gnixoag/PHL-03-/1.jpg

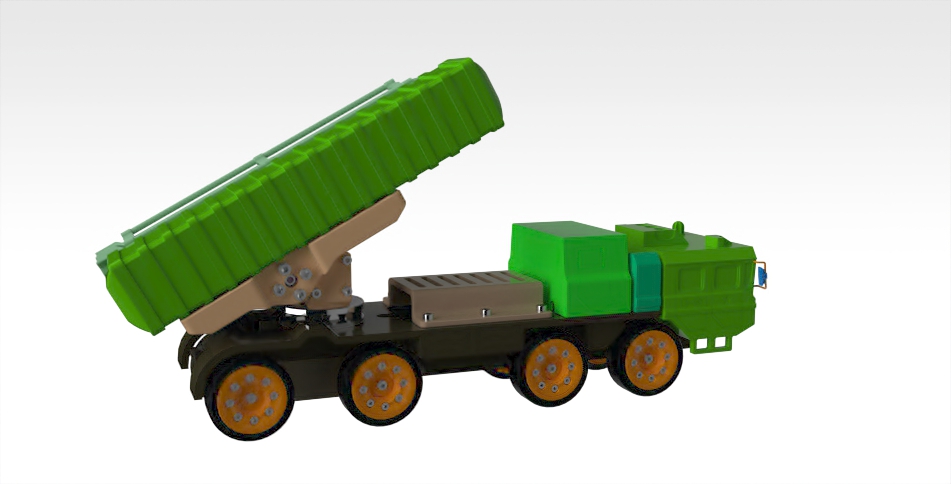
1.jpg
