gnixoag/PHL-03-/PHL-03式远程火箭炮_asm1.tif

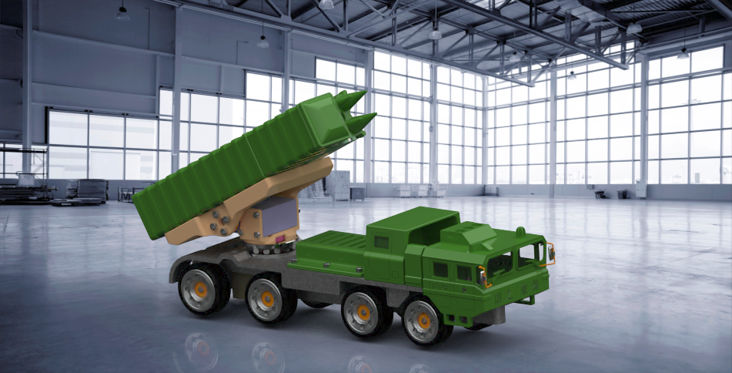
PHL-03式远程火箭炮_asm1.tif
