gnixoag/PHL-03-/2.jpg

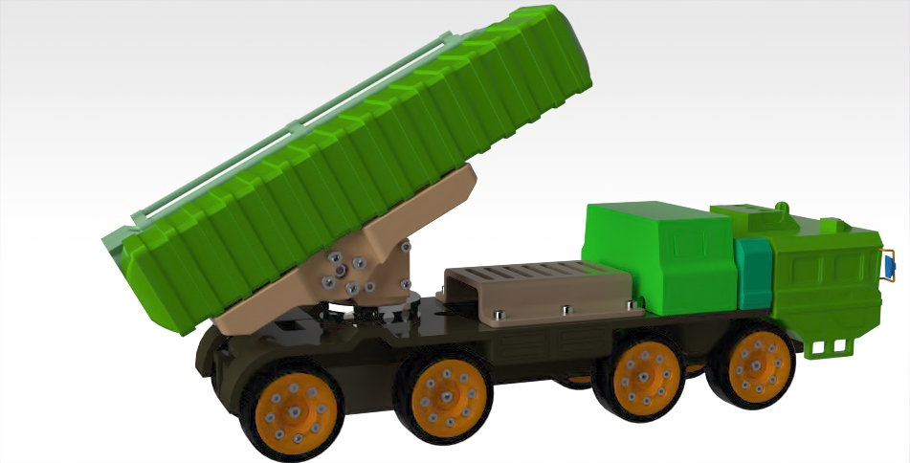
2.jpg
