gnixoag/PHL-03-/单轴舵机.jpg

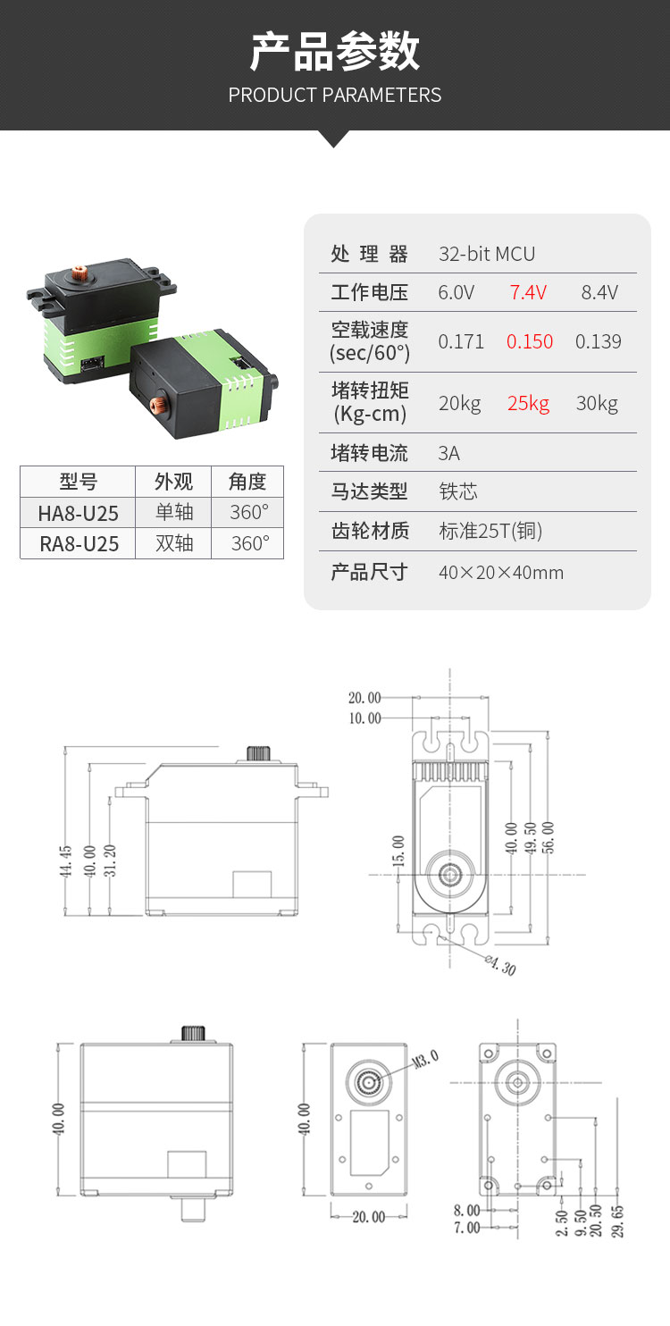
单轴舵机.jpg
