gnixoag/PHL-03-/双轴舵机.jpg

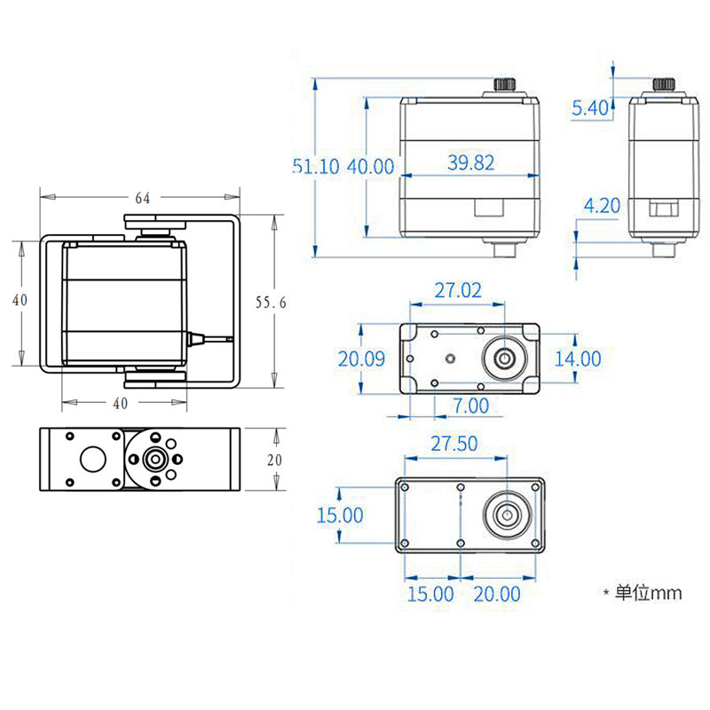
双轴舵机.jpg
