gnixoag/PHL-03-/(list of files, cad)

Other CAD files:
GB-T276_60000_2Z-1994,619I6_2Z.prt
GB-T292_B_C-1994,B723_C.prt
GB-T4663_80000-1994,81105.prt
GB-T70.1-2000,M2.5x6.prt
GB-T70.1-2000,M2x6.prt
GB-T70.1-2000,M3x10.prt
GB-T70.1-2000,M3x30.prt
GB-T70.1-2000,M3x40.prt
GB-T70.1-2000,M3x6.prt
GB-T70.1-2000,M3x8.prt
GB-T70.1-2000,M4x12.prt
GB-T70.1-2000,M4x8.prt
PHL-03副转盘.prt
PHL-03反光镜.prt
PHL-03右反光镜架.prt
PHL-03左反光镜架.prt
PHL-03式远程火箭炮_asm1.prt
PHL-03指挥舱.prt
PHL-03推力转盘.prt
PHL-03水箱.prt
PHL-03炮筒架.prt
PHL-03电池夹.prt
PHL-03车头.prt
PHL-03车头架.prt
PHL-03车架.prt
PHL-03车轮组件_asm1.prt
PHL-03车轴.prt
PHL-03轮毂.prt
PHL-03轮毂盖.prt
PHL-03轮毂轴承盖.prt
PHL-03轮胎.prt
单轴舵机.prt
双轴舵机.prt
火龙-140固体发动机段.prt
火龙-140安装板.prt
火龙-140尾翼.prt
火龙-140引信.prt
火龙-140战斗部.prt
火龙-140火箭弹_asm1.prt
火龙-140火箭架.prt
火龙-480制动器.prt
火龙-480制导弹头.prt
火龙-480发射箱盖.prt
火龙-480发射箱（一段）.prt
火龙-480发射箱（二段）.prt
火龙-480尾翼.prt
火龙-480尾翼段.prt
火龙-480弹簧芯.prt
火龙-480战斗部.prt
火龙-480推进器.prt
火龙-480火箭弹_asm1.prt
直杆型导向轴CSFD-D3-L159.prt
舵盘.prt
