gnixoag/PHL-03-/PHL-03式远程火箭炮图纸2019.10.30.pdf

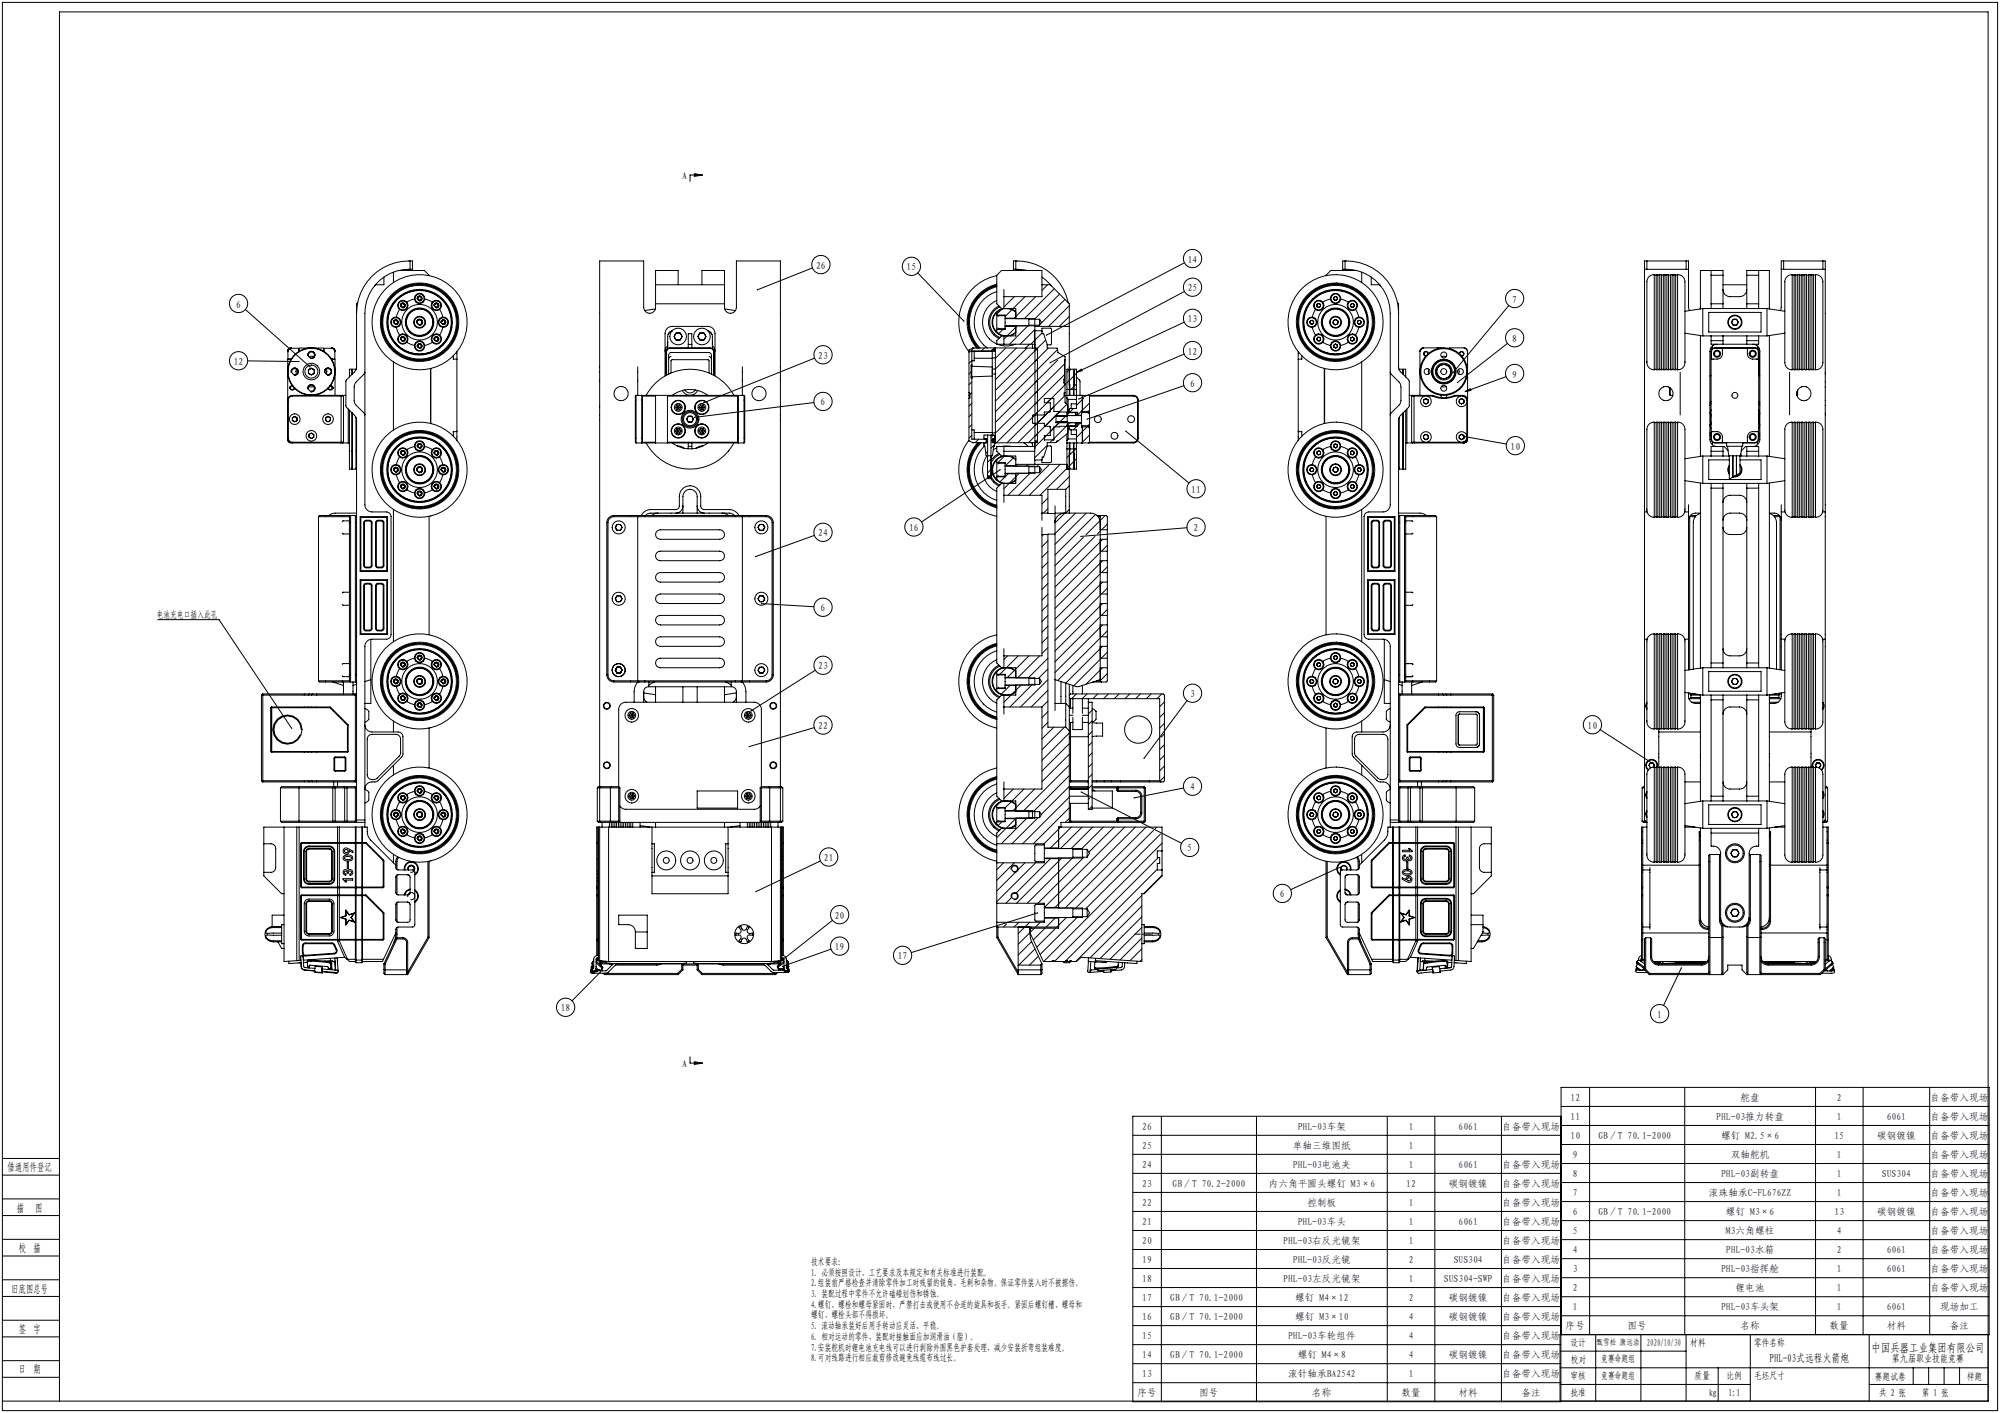
[picture p6: page 1]

12 | | 舵盘 | 2 | | 自备带入现场

11 | | PHL-03推力转盘 | 1 | 6061 | 自备带入现场

26 | | PHL-03车架 | 1 | 6061 | 自备带入现场

10 | GB／T 70.1-2000 | 螺钉 M2.5×6 | 15 | 碳钢镀镍 | 自备带入现场

25 | | 单轴三维图纸 | 1

9 | | 双轴舵机 | 1 | | 自备带入现场

24 | | PHL-03电池夹 | 1 | 6061 | 自备带入现场

8 | | PHL-03副转盘 | 1 | SUS304 | 自备带入现场

23 | GB／T 70.2-2000 | 内六角平圆头螺钉 M3×6 | 12 | 碳钢镀镍 | 自备带入现场

7 | | 滚珠轴承C-FL676ZZ | 1 | | 自备带入现场

22 | | 控制板 | 1 | | 自备带入现场

6 | GB／T 70.1-2000 | 螺钉 M3×6 | 13 | 碳钢镀镍 | 自备带入现场

21 | | PHL-03车头 | 1 | 6061 | 自备带入现场

5 | | M3六角螺柱 | 4 | | 自备带入现场

20 | | PHL-03右反光镜架 | 1 | | 自备带入现场

技术要求：
1. 必须按照设计、工艺要求及本规定和有关标准进行装配。
2.组装前严格检查并清除零件加工时残留的锐角、毛刺和杂物。保证零件装入时不被擦伤。
3. 装配过程中零件不允许磕碰划伤和锈蚀。
4.螺钉、螺栓和螺母紧固时，严禁打击或使用不合适的旋具和扳手。紧固后螺钉槽、螺母和
螺钉、螺栓头部不得损坏。
5. 滚动轴承装好后用手转动应灵活、平稳。
6. 相对运动的零件，装配时接触面应加润滑油（脂）。
7.安装舵机时锂电池充电线可以进行剥除外围黑色护套处理，减少安装折弯组装难度。
8.可对线路进行相应裁剪修改避免线缆布线过长。

19 | | PHL-03反光镜 | 2 | SUS304 | 自备带入现场

18 | | PHL-03左反光镜架 | 1 | SUS304-SWP | 自备带入现场

17 | GB／T 70.1-2000 | 螺钉 M4×12 | 2 | 碳钢镀镍 | 自备带入现场

1 | | PHL-03车头架 | 1 | 6061 | 现场加工

16 | GB／T 70.1-2000 | 螺钉 M3×10 | 4 | 碳钢镀镍 | 自备带入现场

序号 | 图号 | 名称 | 数量 | 材料 | 备注
设计 | 甄雪松 康远浩 | 2020/10/30 | 材料 | 零件名称 PHL-03式远程火箭炮 | 中国兵器工业集团有限公司 第九届职业技能竞赛
校对 | 竞赛命题组

14 | GB／T 70.1-2000 | 螺钉 M4×8 | 4 | 碳钢镀镍 | 自备带入现场

审核 | 竞赛命题组 | | 质量 | 比例 | 毛坯尺寸 | 赛题试卷 | | 样题

13 | | 滚针轴承BA2542 | 1 | | 自备带入现场

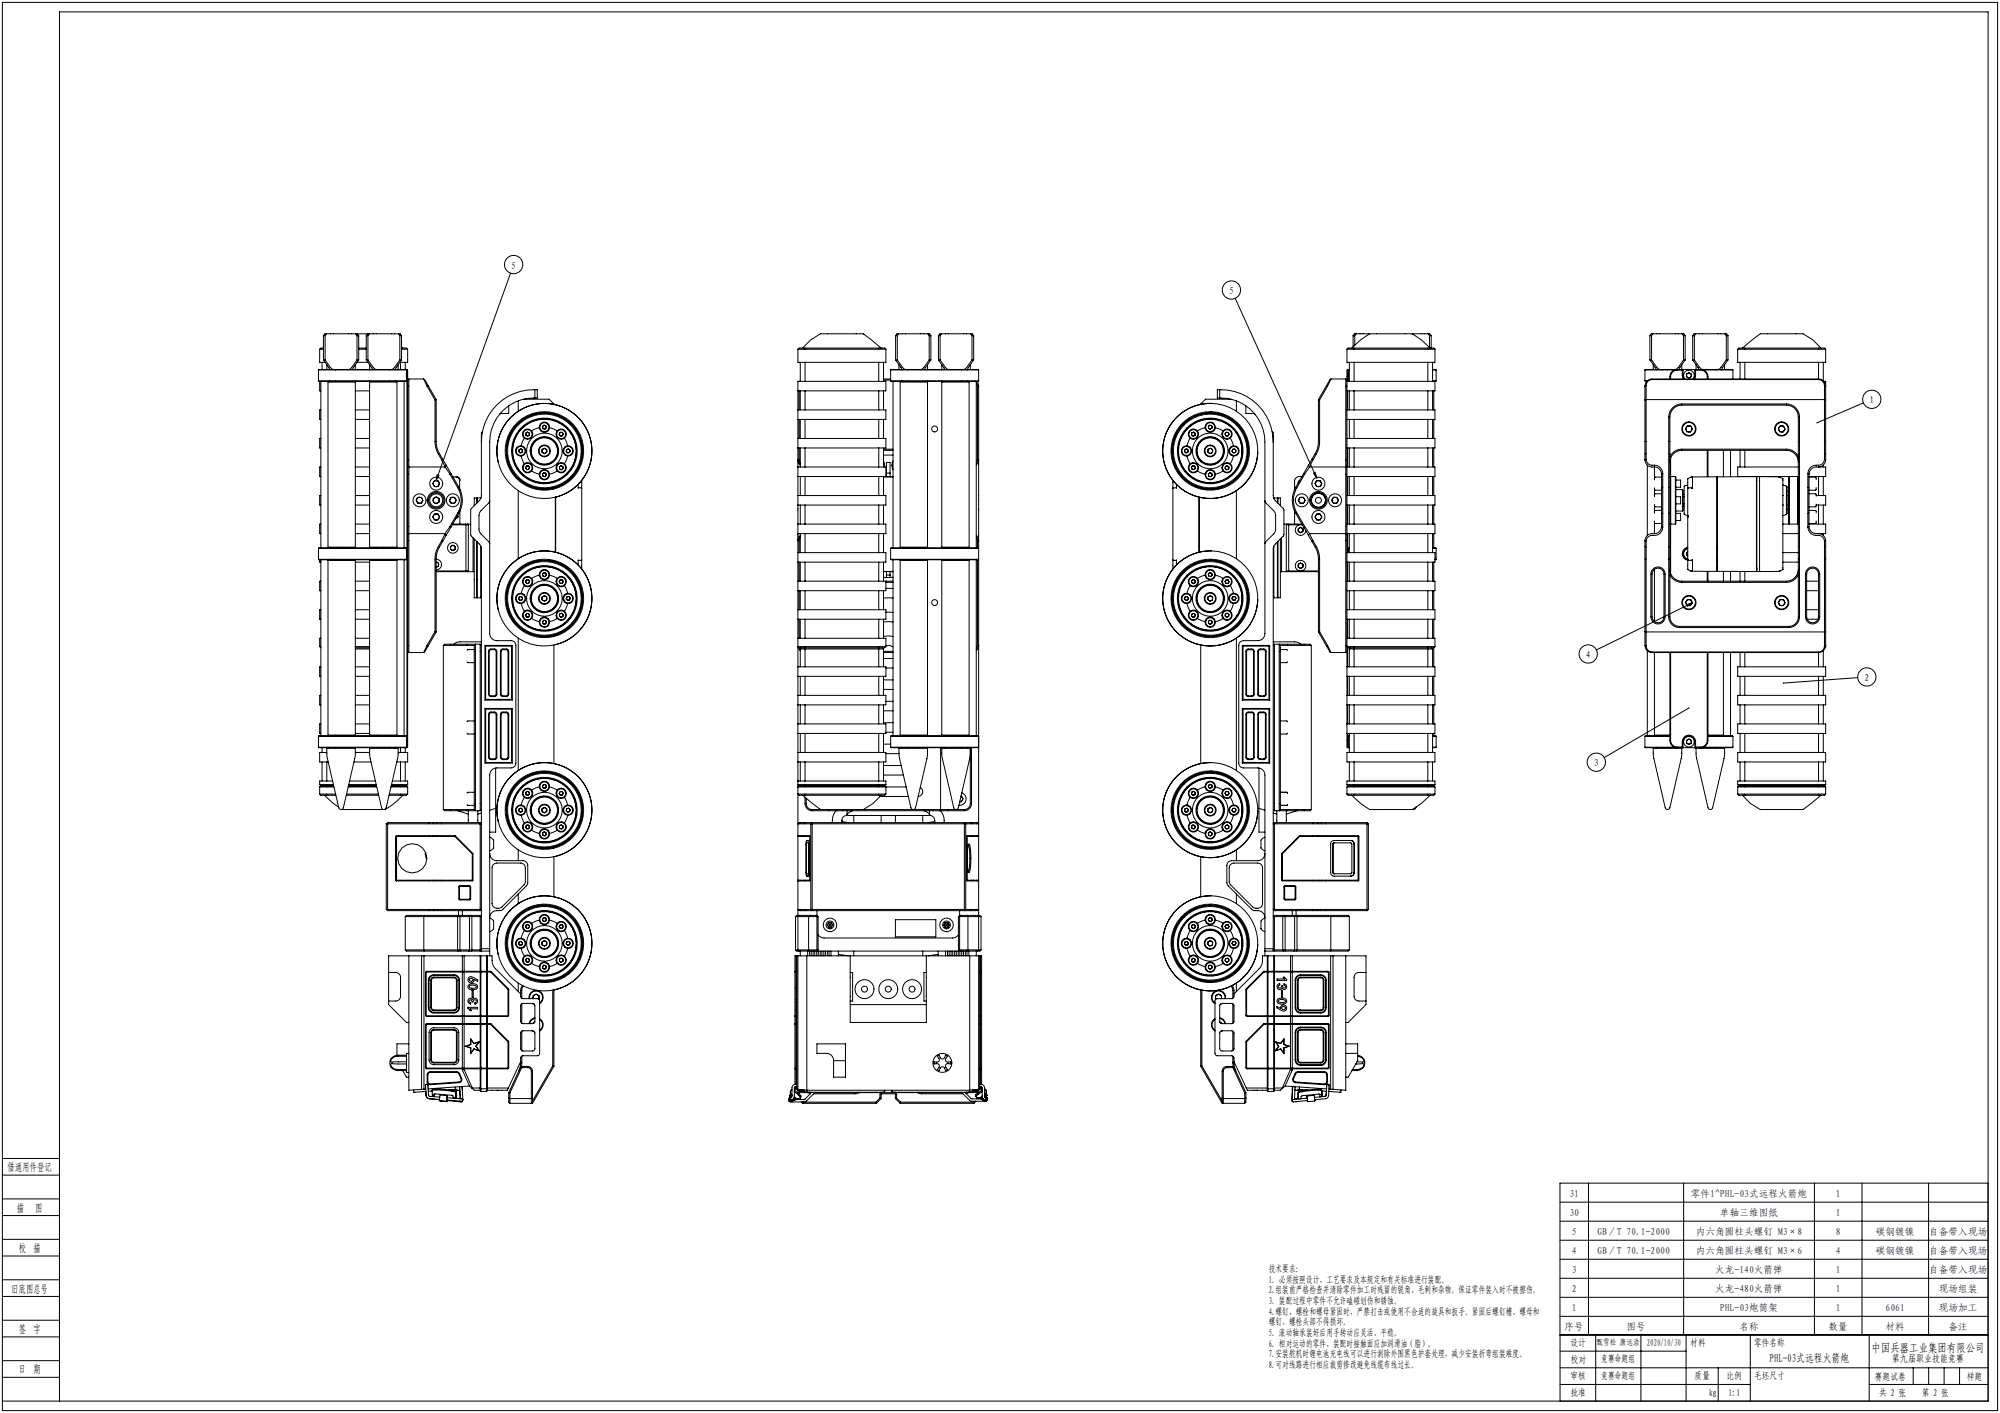
[picture p7: page 2]
内六角圆柱头螺钉 M3×6; 碳钢镀镍; 自备带入现场

31 | | 零件1^PHL-03式远程火箭炮 | 1

30 | | 单轴三维图纸 | 1

5 | GB／T 70.1-2000 | 内六角圆柱头螺钉 M3×8 | 8 | 碳钢镀镍 | 自备带入现场

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

1 | | PHL-03炮筒架 | 1 | 6061 | 现场加工

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

竞赛命题组 | 质量 | | 毛坯尺寸 | | 样题

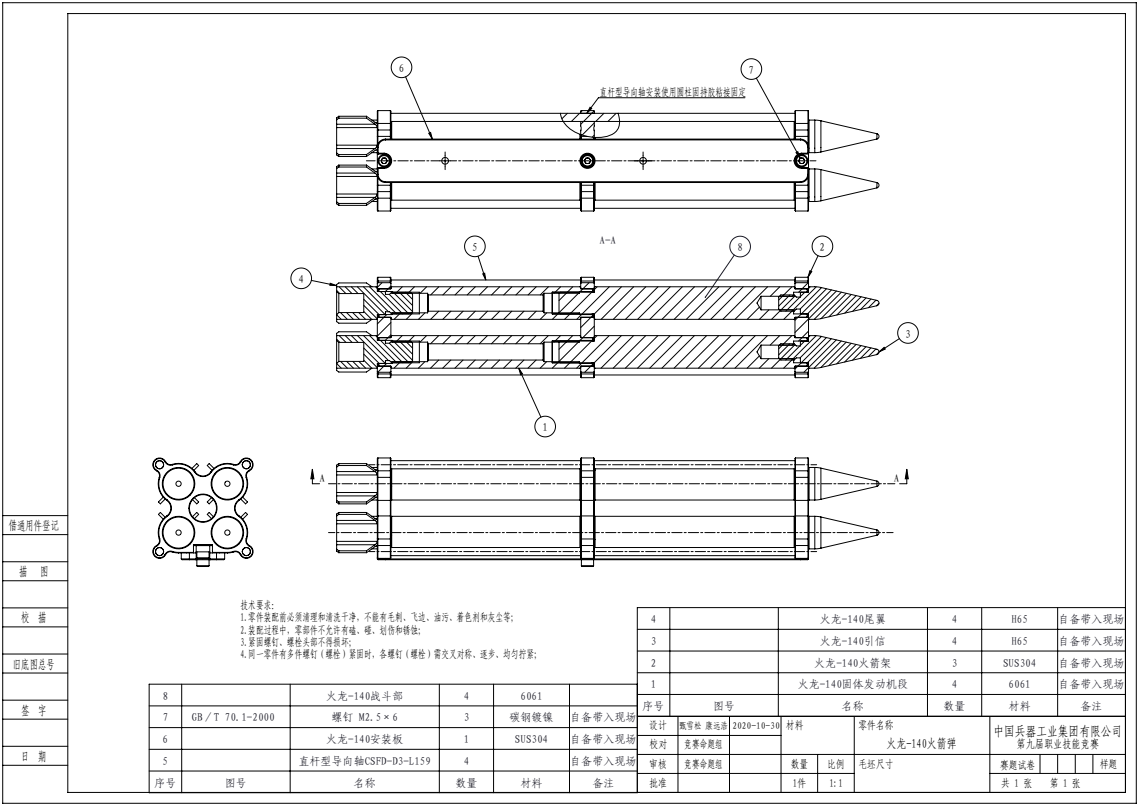
[picture p8: page 3]

技术要求：
1.零件装配前必须清理和清洗干净，不能有毛刺、飞边、油污、着色剂和灰尘等；
2.装配过程中，零部件不允许有磕、碰、划伤和锈蚀；
3.紧固螺钉、螺栓头部不得损坏；
4.同一零件有多件螺钉（螺栓）紧固时，各螺钉（螺栓）需交叉对称、逐步、均匀拧紧；

3 | | 火龙-140引信 | 4 | H65 | 自备带入现场

2 | | 火龙-140火箭架 | 3 | SUS304 | 自备带入现场

1 | | 火龙-140固体发动机段 | 4 | 6061 | 自备带入现场

8 | | 火龙-140战斗部 | 4 | 6061

序号 | 图号 | 名称 | 数量 | 材料 | 备注
设计 | 甄雪松 康远浩 | 2020-10-30 | 材料 | 零件名称 火龙-140火箭弹 | 中国兵器工业集团有限公司

7 | GB／T 70.1-2000 | 螺钉 M2.5×6 | 3 | 碳钢镀镍 | 自备带入现场

6 | | 火龙-140安装板 | 1 | SUS304 | 自备带入现场

5 | | 直杆型导向轴CSFD-D3-L159 | 4 | | 自备带入现场

数量 | | | | 样题
1件 | 1:1 | | 共 1 张 第 1 张

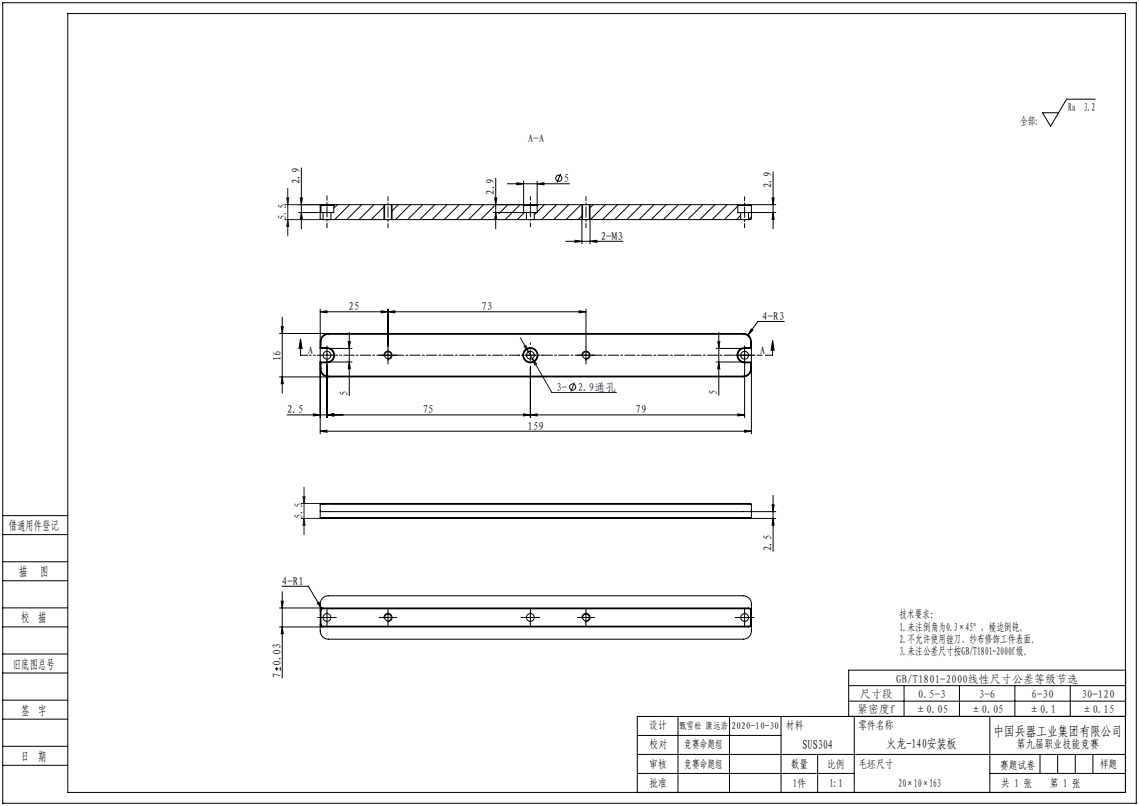
[picture p9: page 4]
甄雪松 康远浩

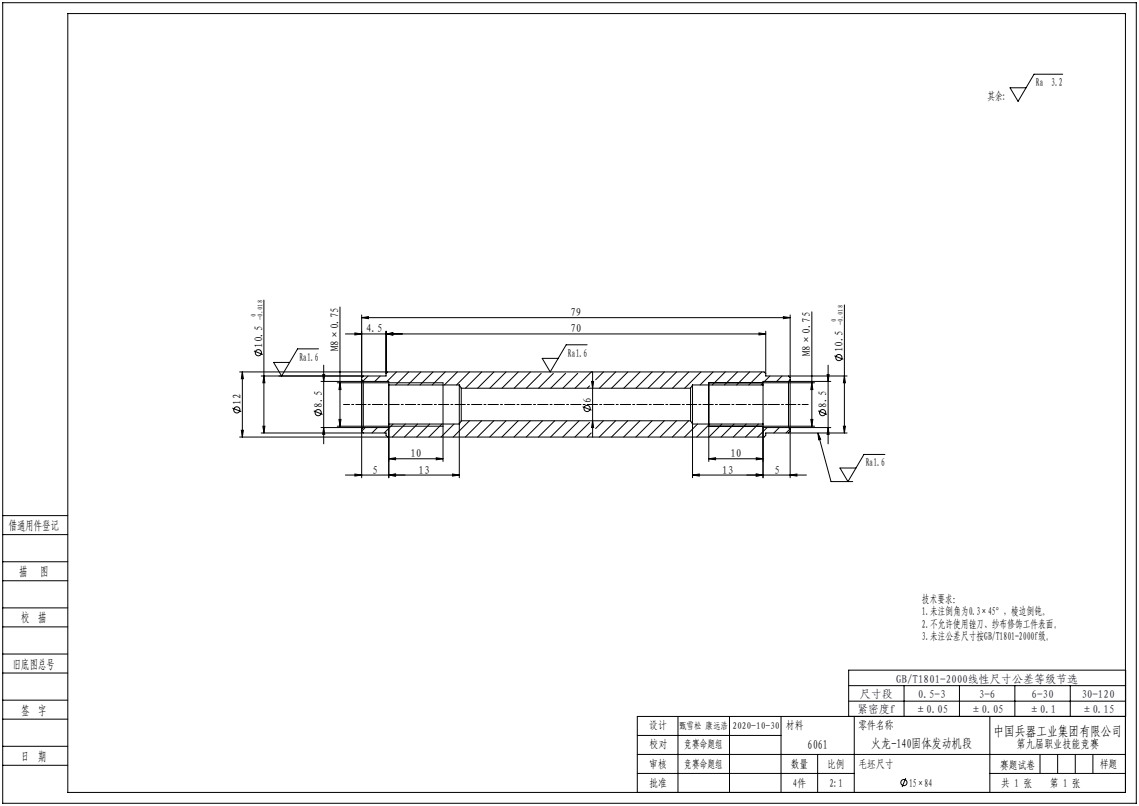
[picture p10: page 5]
甄雪松 康远浩

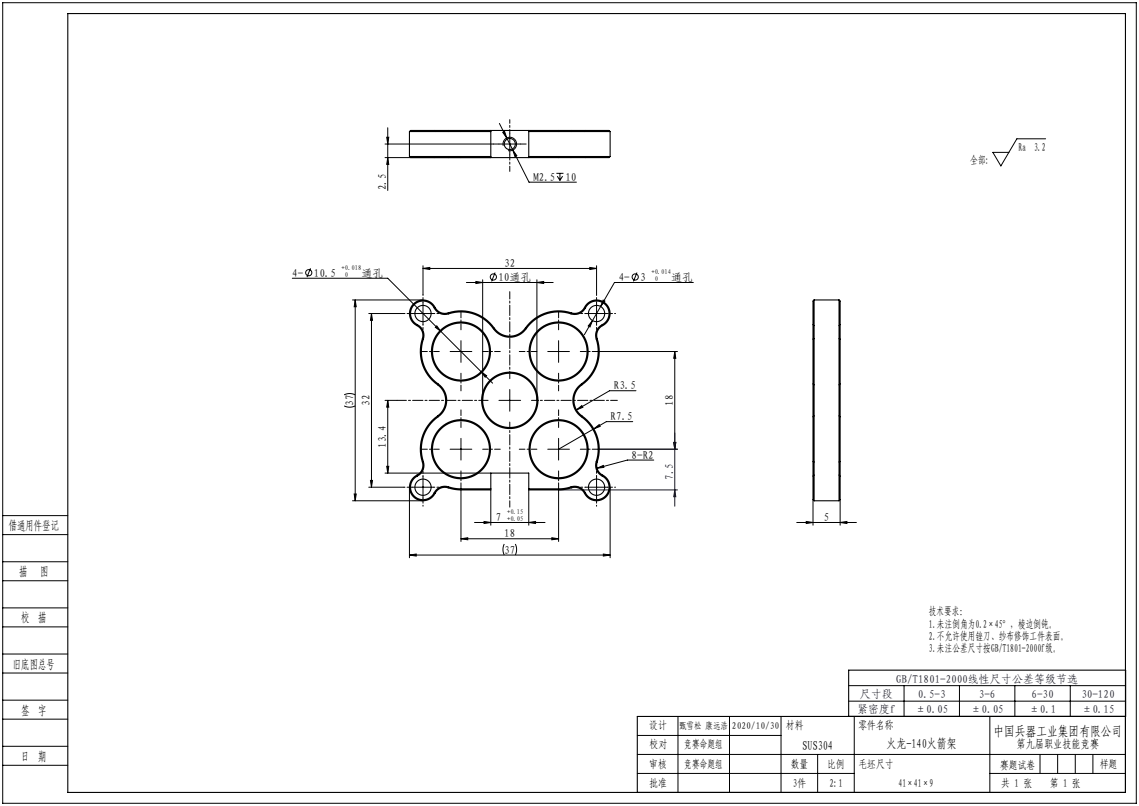
[picture p11: page 6]
甄雪松 康远浩

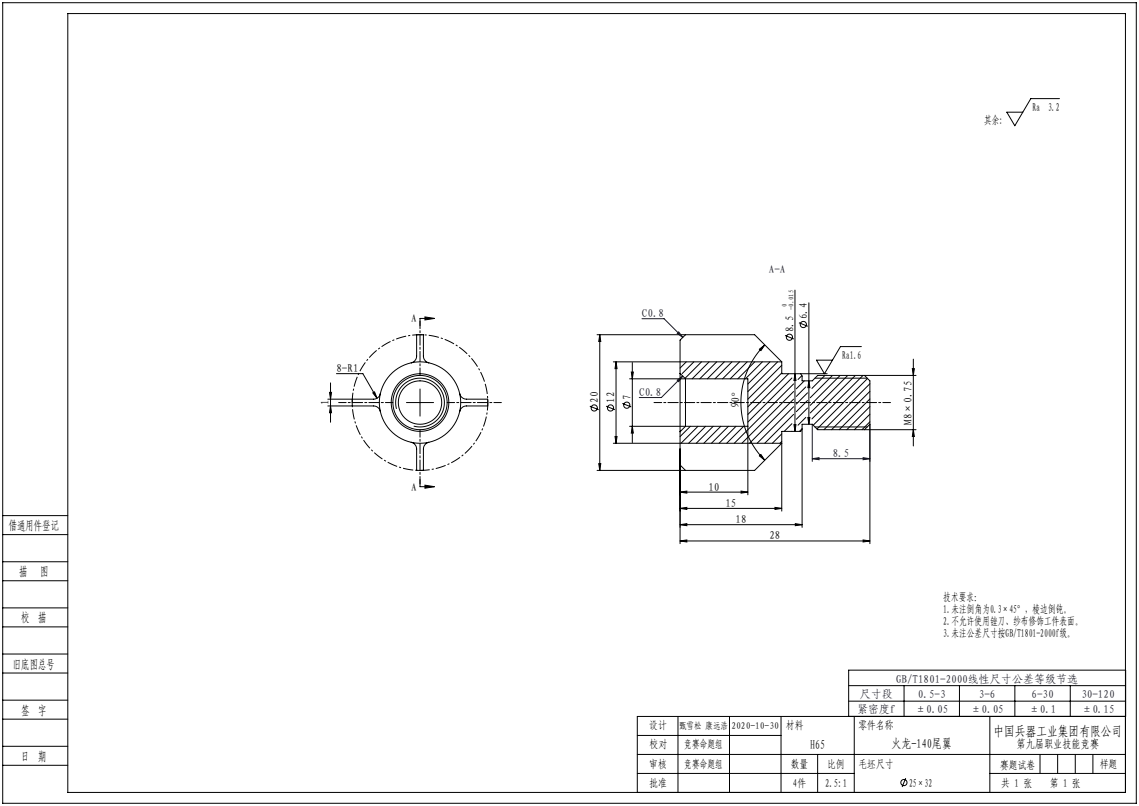
[picture p12: page 7]
甄雪松 康远浩

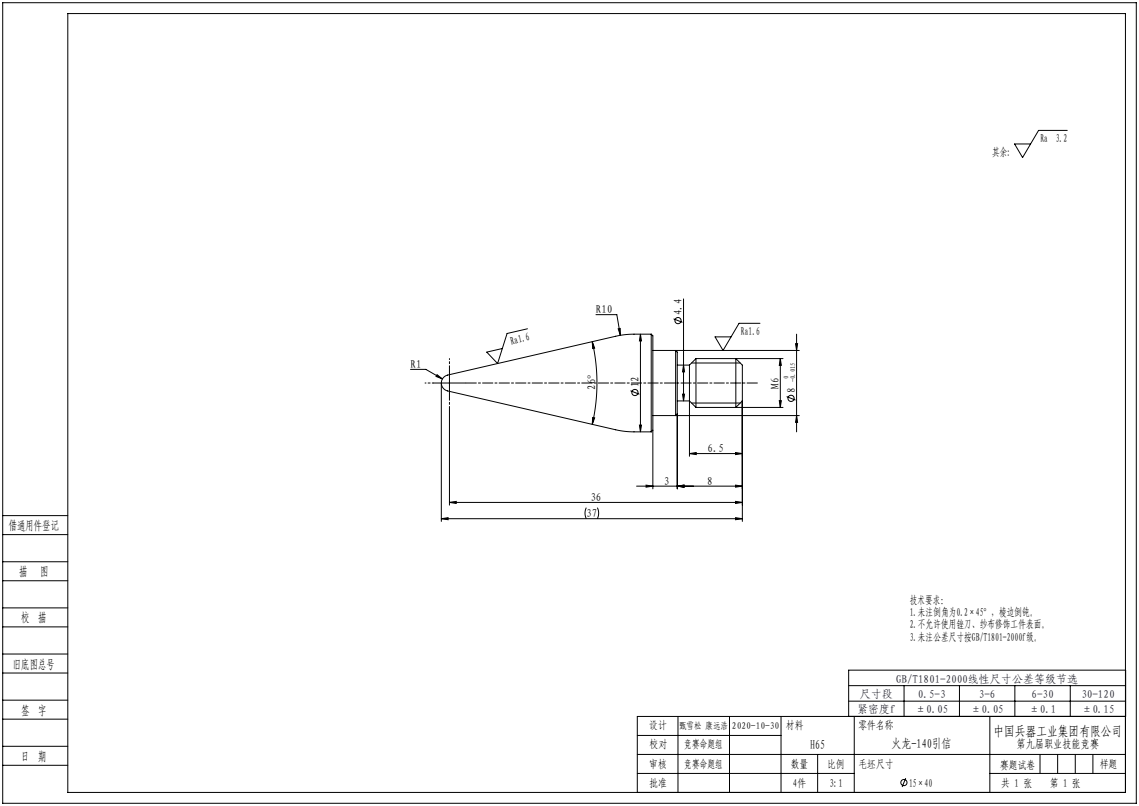
[picture p13: page 8]
甄雪松 康远浩

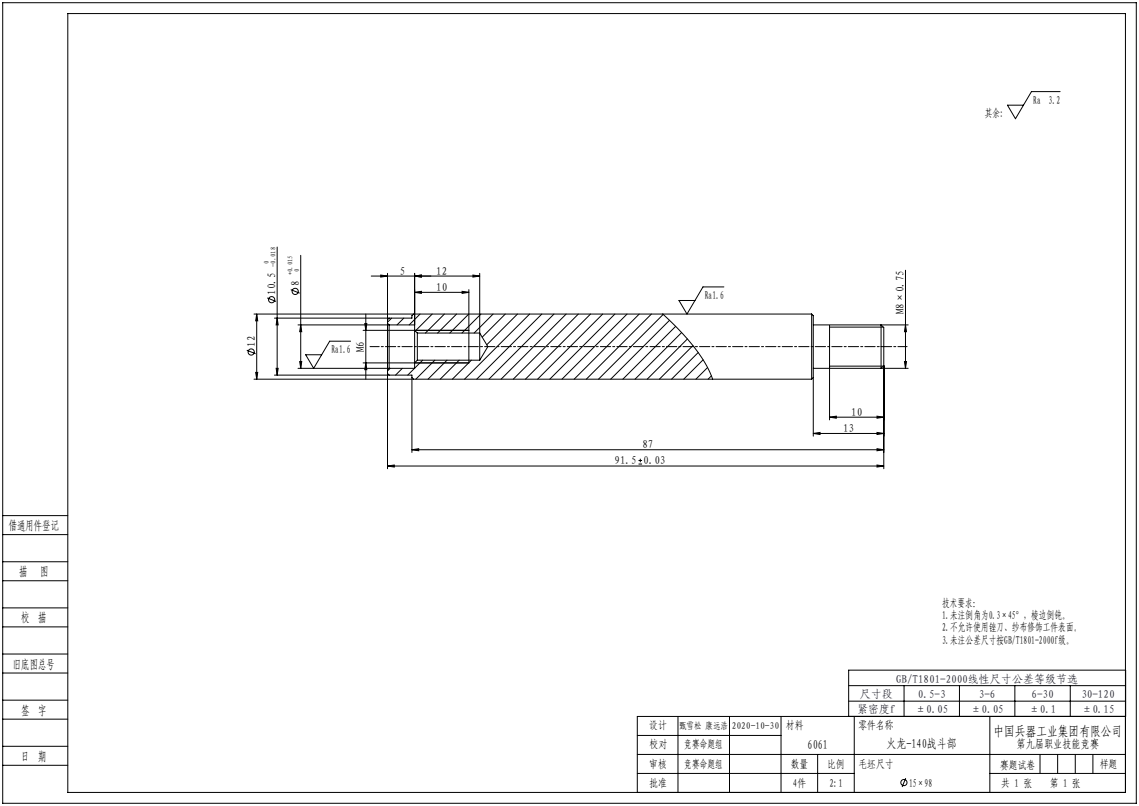
[picture p14: page 9]
甄雪松 康远浩

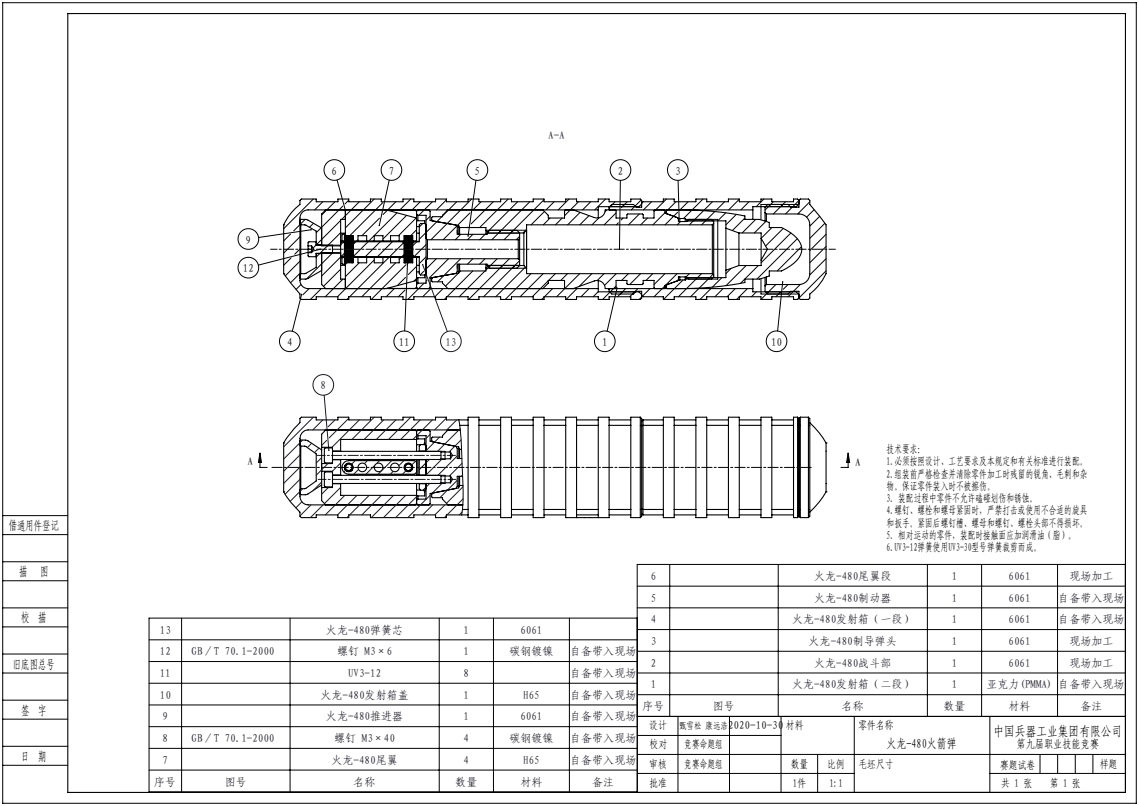
[picture p15: page 10]

技术要求：
1.必须按照设计、工艺要求及本规定和有关标准进行装配。
2.组装前严格检查并清除零件加工时残留的锐角、毛刺和杂
物。保证零件装入时不被擦伤。
3. 装配过程中零件不允许磕碰划伤和锈蚀。
4.螺钉、螺栓和螺母紧固时，严禁打击或使用不合适的旋具
和扳手。紧固后螺钉槽、螺母和螺钉、螺栓头部不得损坏。
5. 相对运动的零件，装配时接触面应加润滑油（脂）。
6.UV3-12弹簧使用UV3-30型号弹簧裁剪而成。

6 | 火龙-480尾翼段 | 1 | 6061 | 现场加工

5 | 火龙-480制动器 | 1 | 6061 | 自备带入现场

13 | | 火龙-480弹簧芯 | 1 | 6061

3 | | 火龙-480制导弹头 | 1 | 6061 | 现场加工

12 | GB／T 70.1-2000 | 螺钉 M3×6 | 1 | 碳钢镀镍 | 自备带入现场

2 | | 火龙-480战斗部 | 1 | 6061 | 现场加工

11 | | UV3-12 | 8 | | 自备带入现场

1 | | 火龙-480发射箱（二段） | 1 | 亚克力(PMMA) | 自备带入现场

10 | | 火龙-480发射箱盖 | 1 | H65 | 自备带入现场

序号 | 图号 | 名称 | 数量 | 材料 | 备注
设计 | 甄雪松 康远浩2020-10-30 | | 材料 | 零件名称 火龙-480火箭弹 | 中国兵器工业集团有限公司

9 | | 火龙-480推进器 | 1 | 6061 | 自备带入现场

8 | GB／T 70.1-2000 | 螺钉 M3×40 | 4 | 碳钢镀镍 | 自备带入现场

7 | | 火龙-480尾翼 | 4 | H65 | 自备带入现场

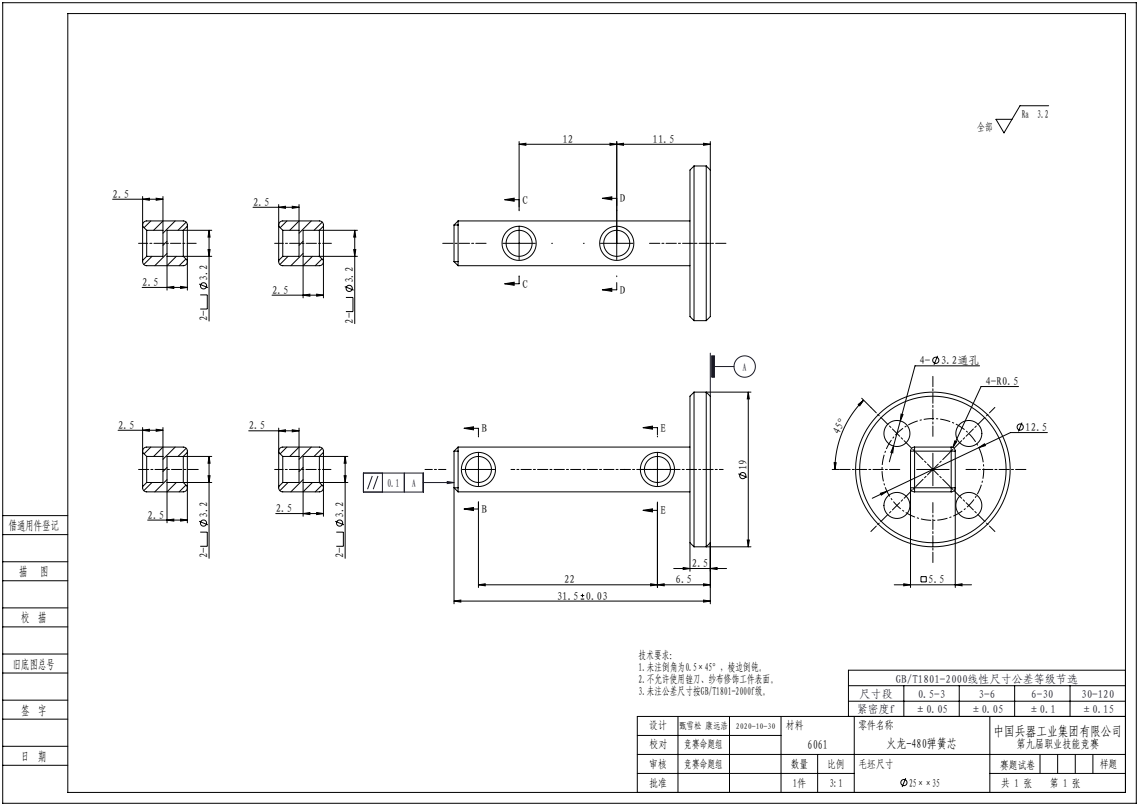
[picture p16: page 11]
甄雪松 康远浩

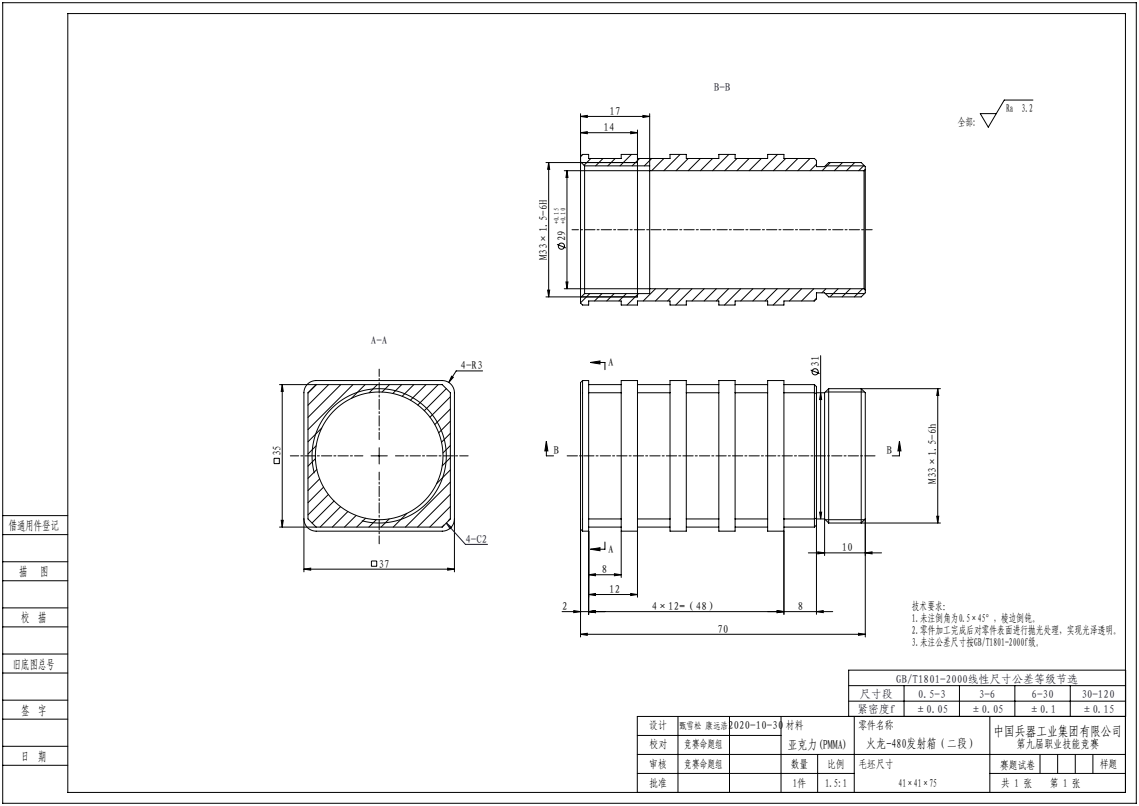
[picture p17: page 12]
甄雪松 康远浩2020-10-30

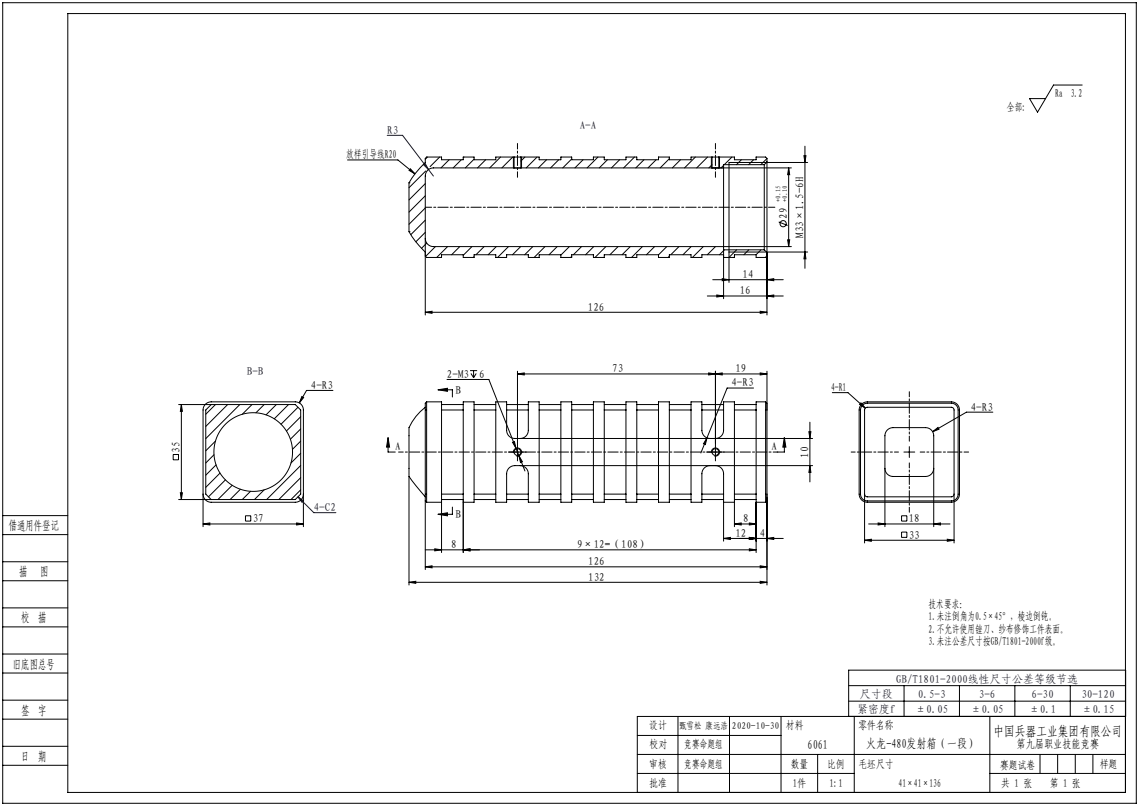
[picture p18: page 13]
甄雪松 康远浩

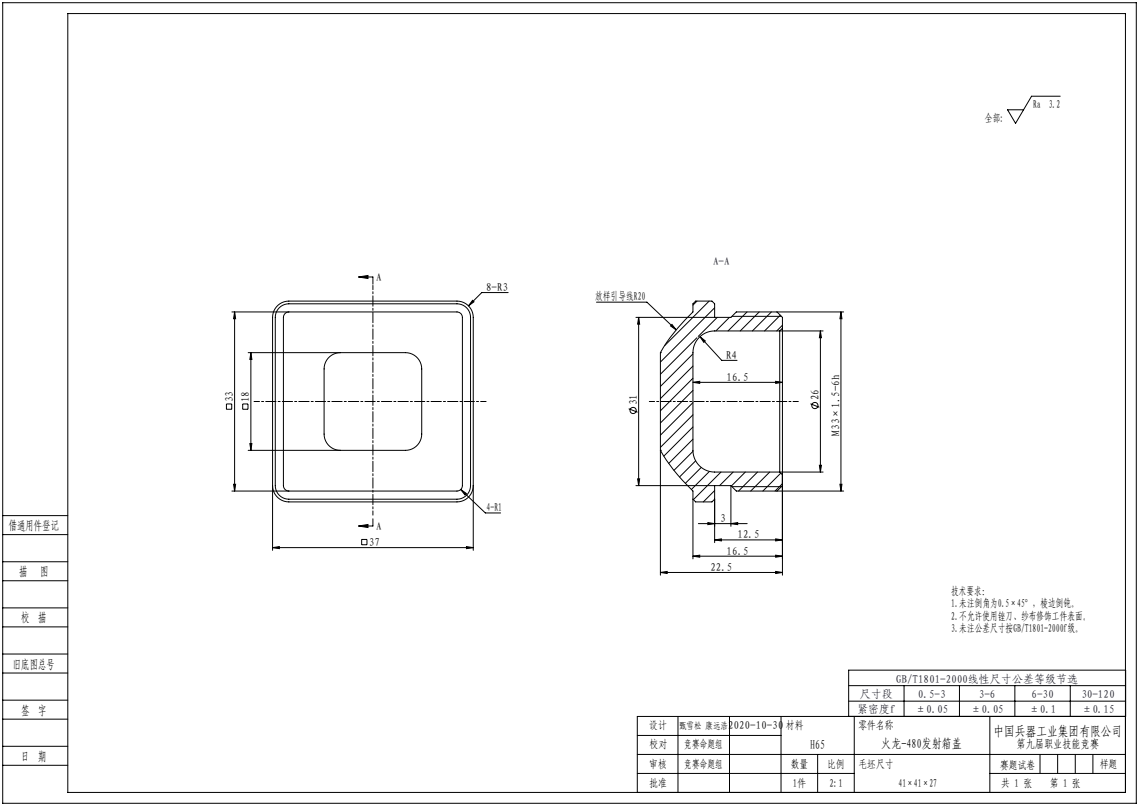
[picture p19: page 14]
甄雪松 康远浩2020-10-30

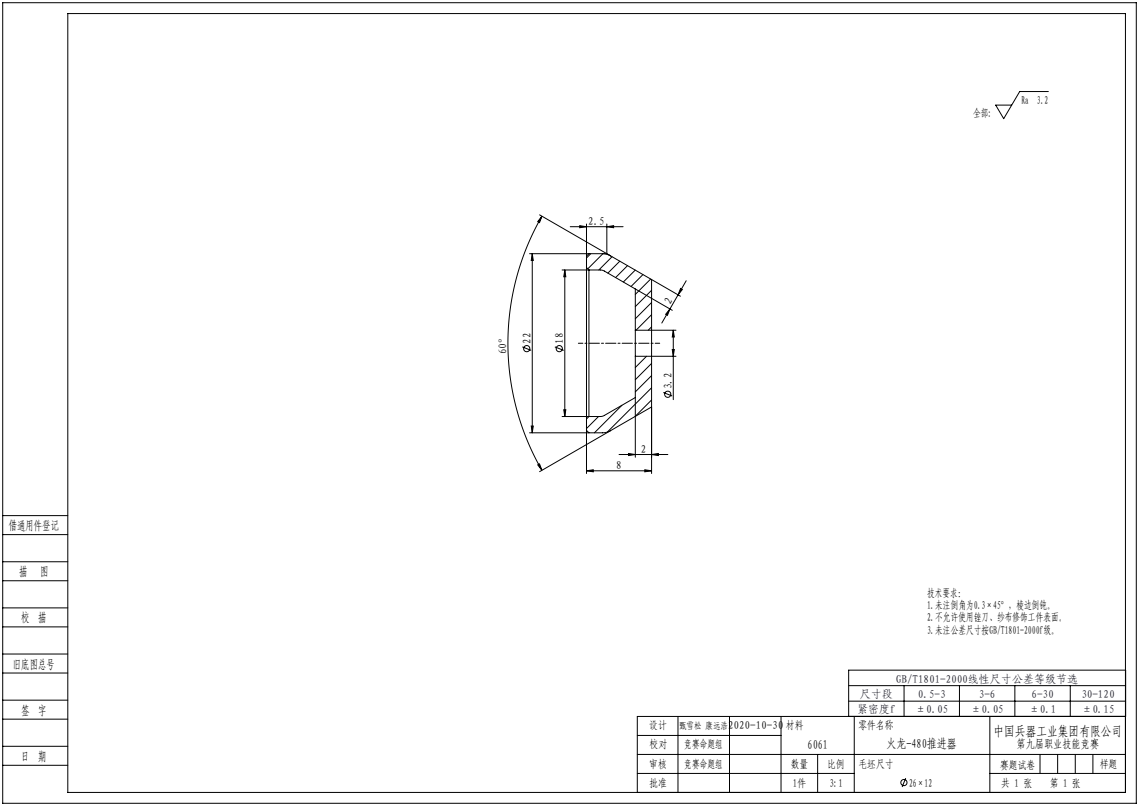
[picture p20: page 15]
甄雪松 康远浩2020-10-30

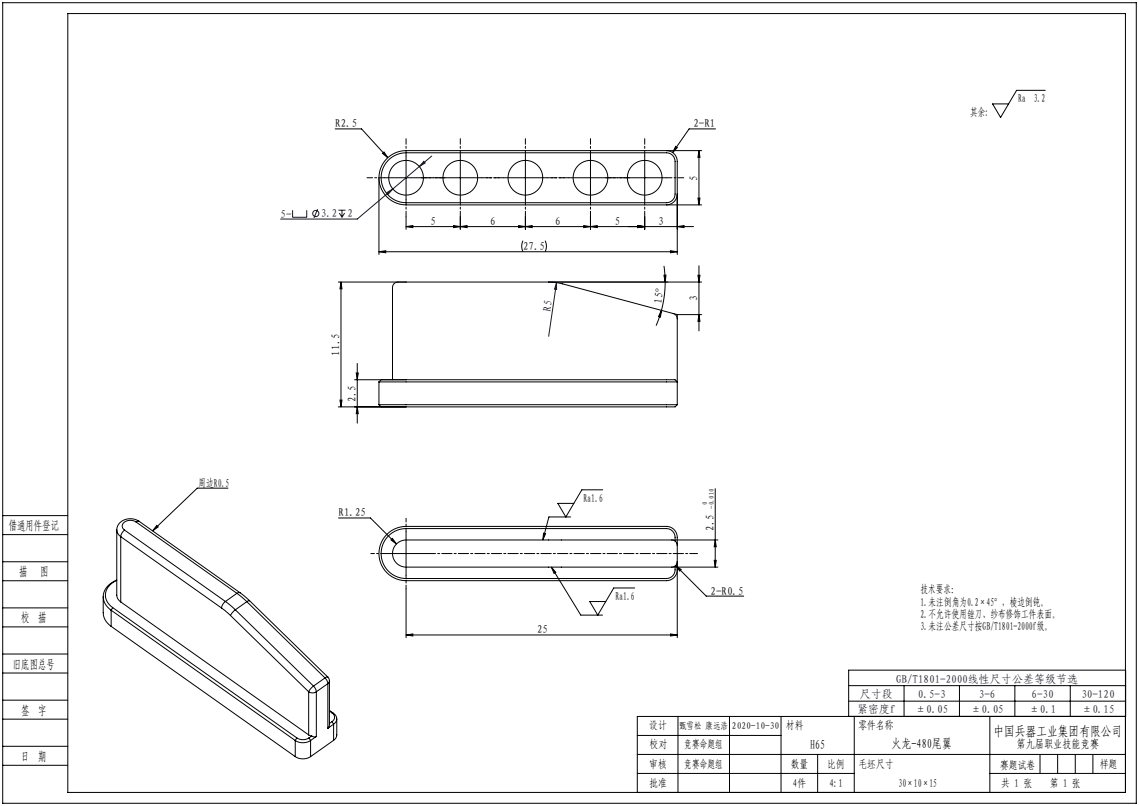
[picture p21: page 16]
甄雪松 康远浩

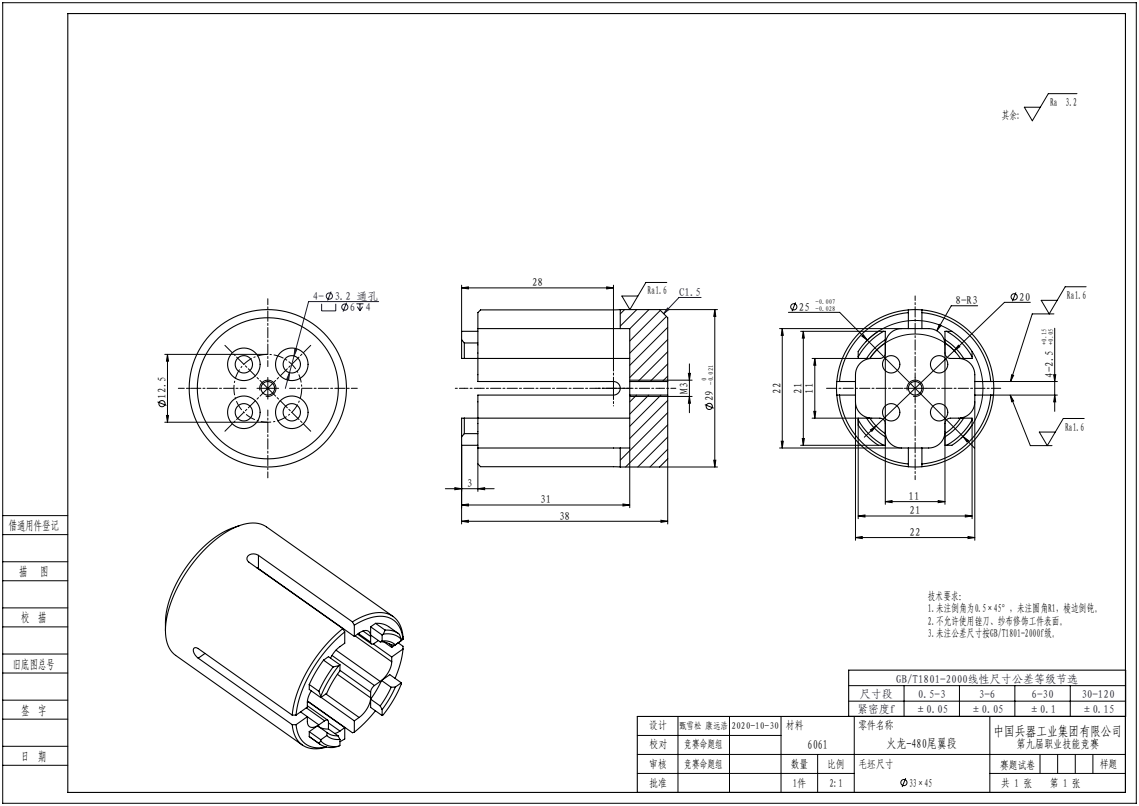
[picture p22: page 17]
甄雪松 康远浩

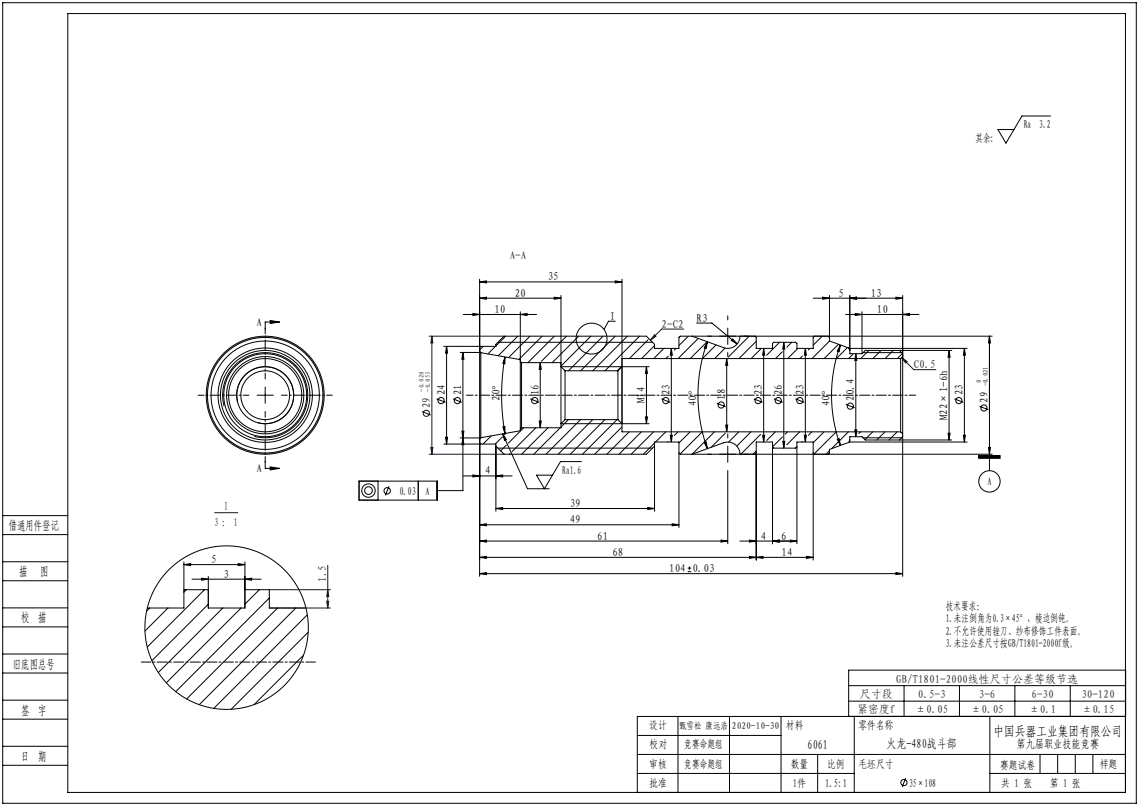
[picture p23: page 18]
甄雪松 康远浩

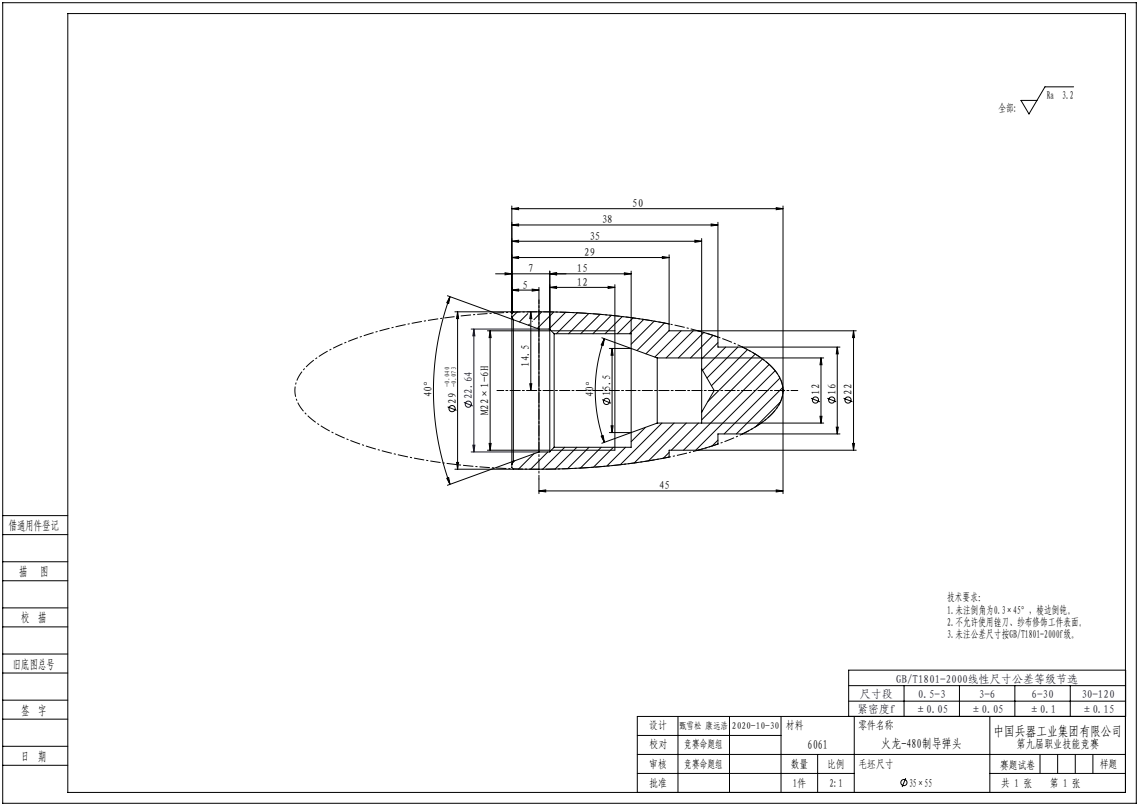
[picture p24: page 19]
甄雪松 康远浩

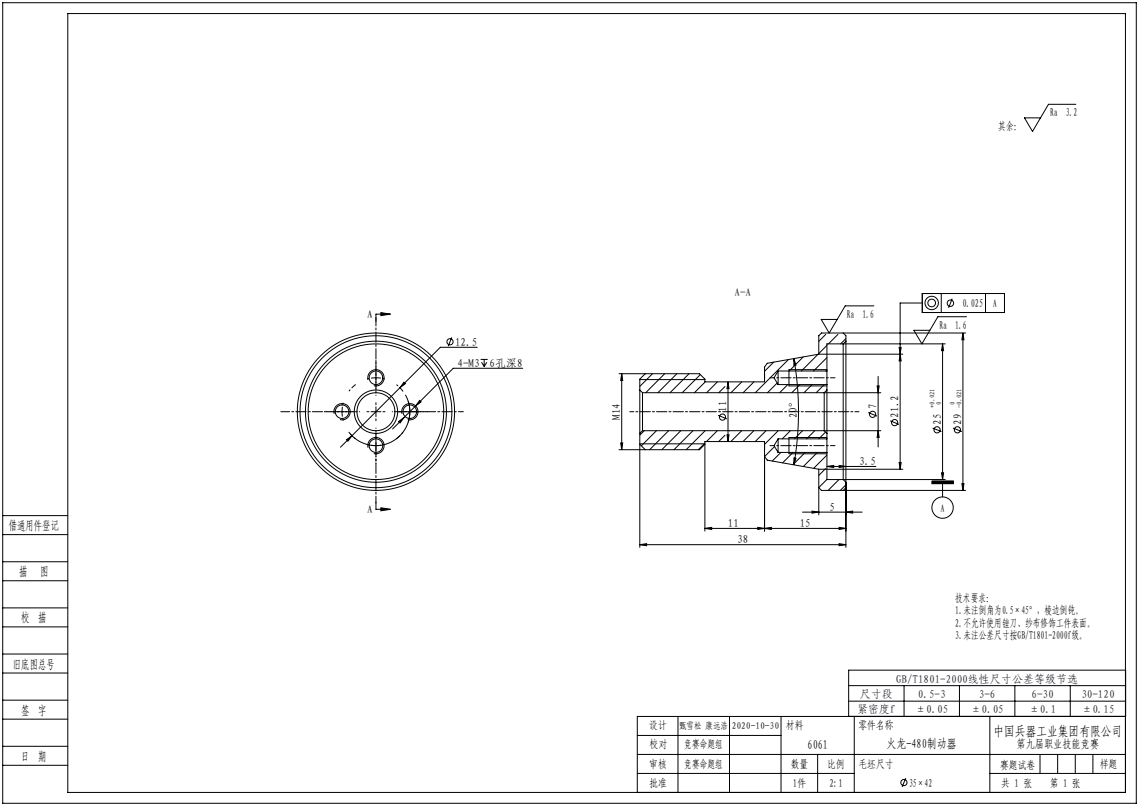
[picture p25: page 20]
甄雪松 康远浩

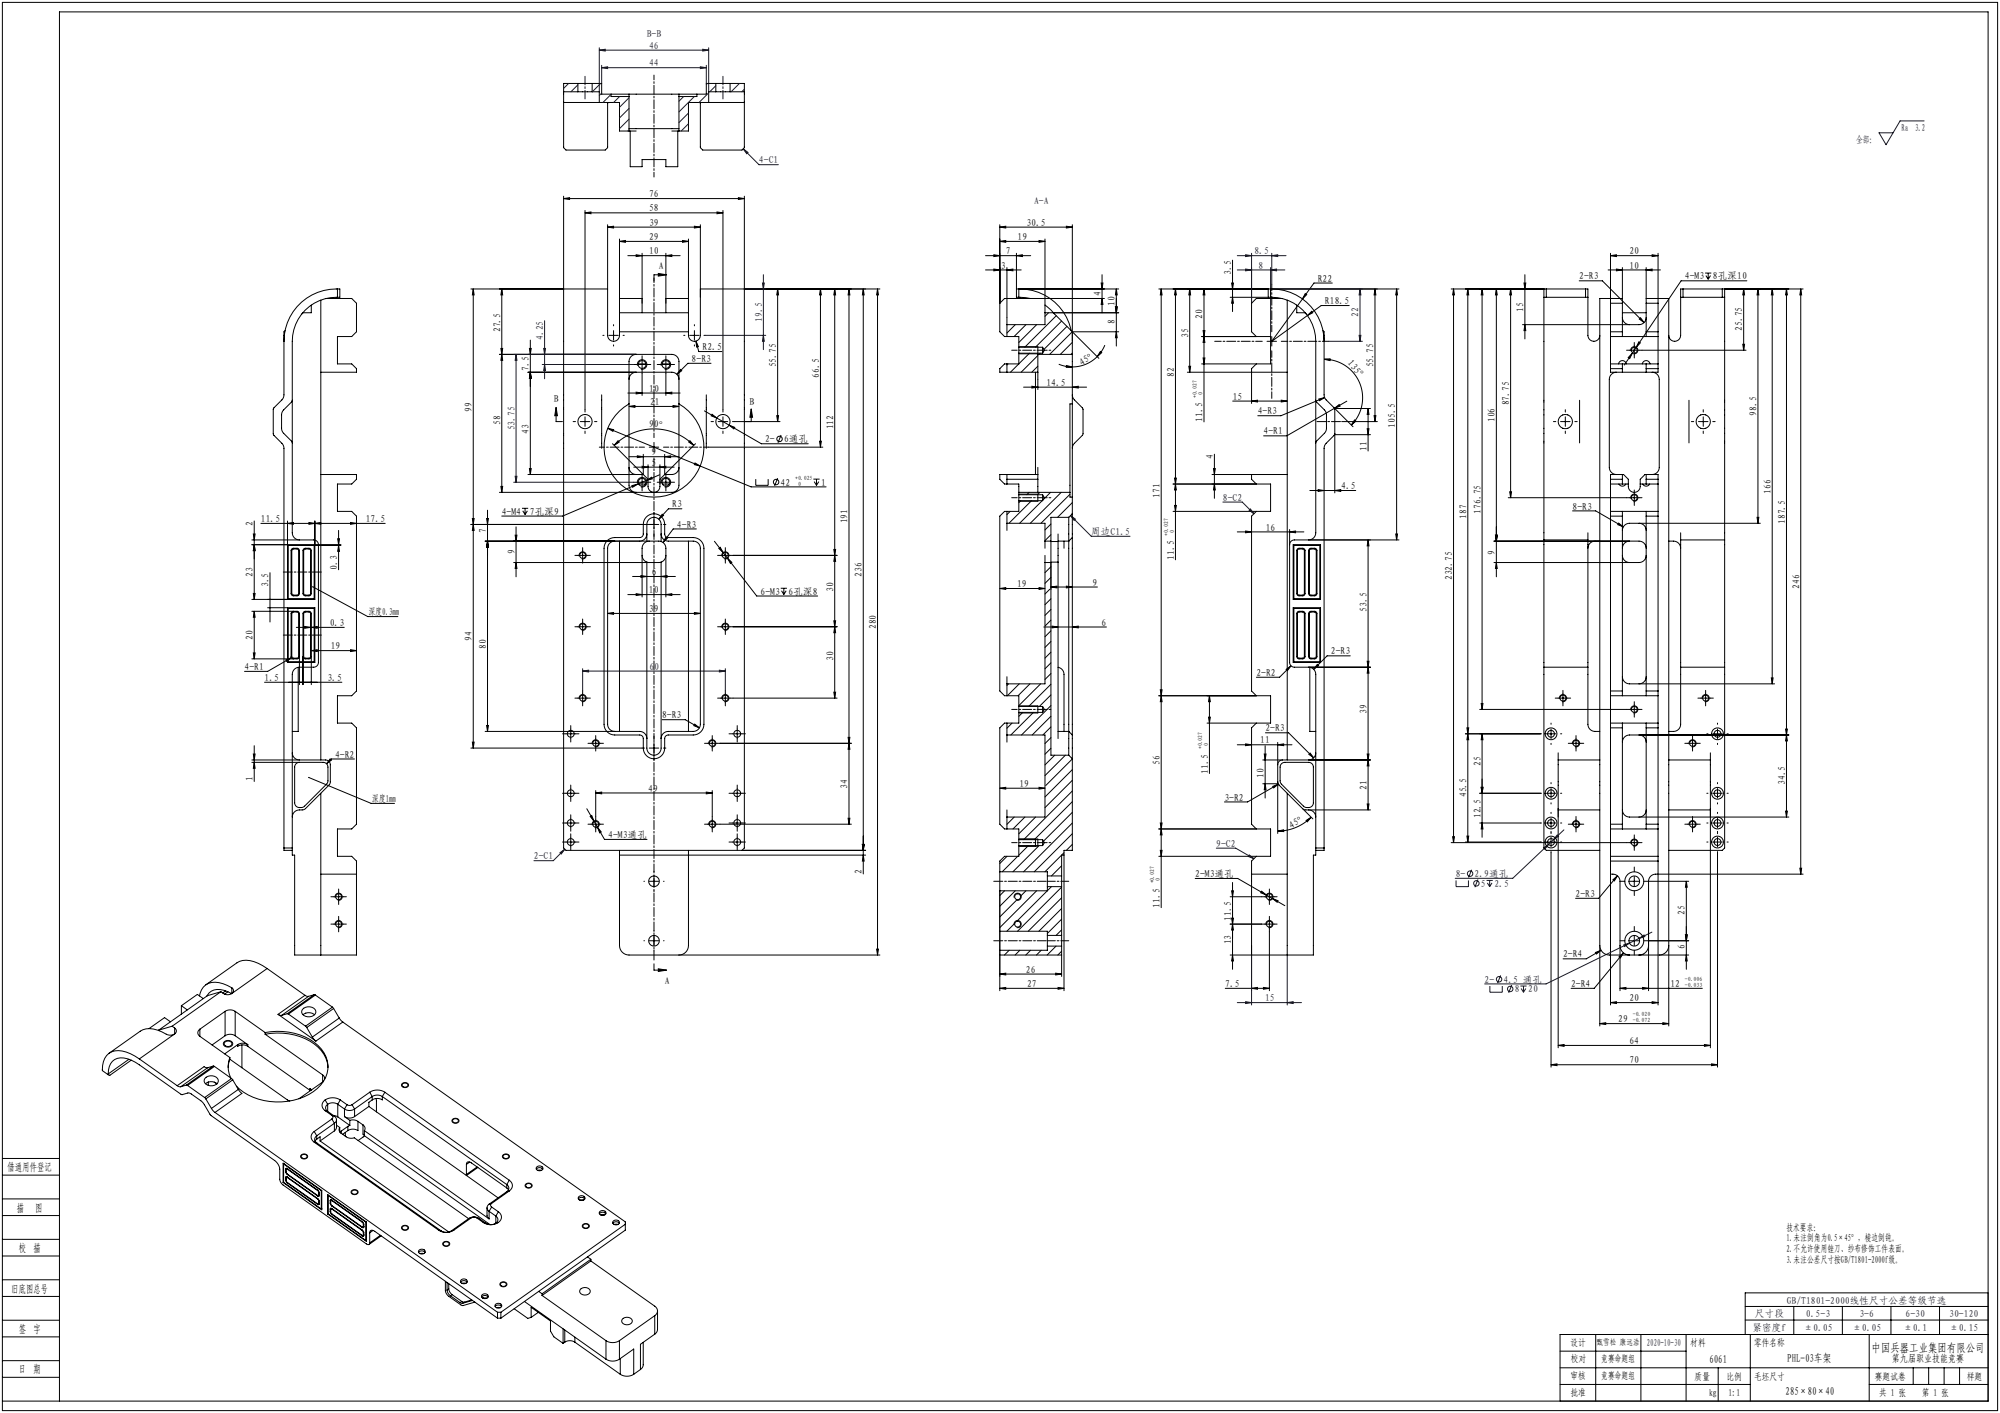
[picture p26: page 21]
甄雪松 康远浩

竞赛命题组 | 质量 | | 285×80×40 | 样题

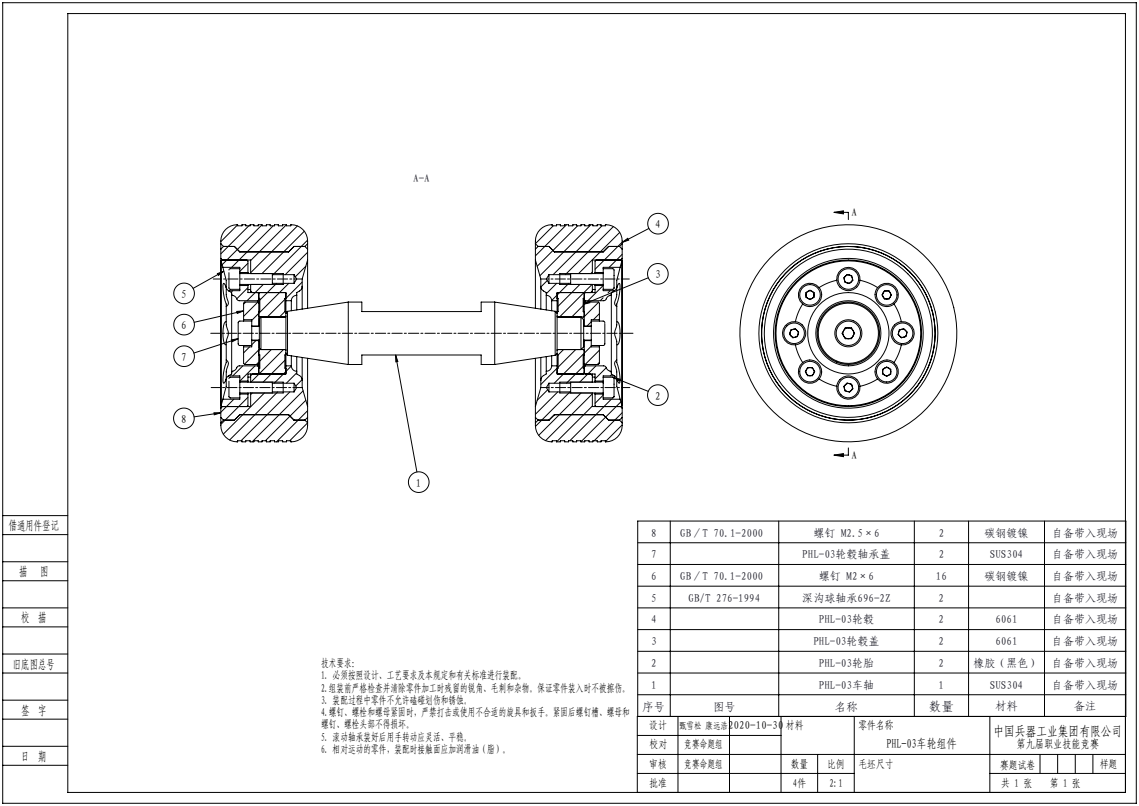
[picture p27: page 22]

8 | GB／T 70.1-2000 | 螺钉 M2.5×6 | 2 | 碳钢镀镍 | 自备带入现场

7 | | PHL-03轮毂轴承盖 | 2 | SUS304 | 自备带入现场

6 | GB／T 70.1-2000 | 螺钉 M2×6 | 16 | 碳钢镀镍 | 自备带入现场

5 | GB/T 276-1994 | 深沟球轴承696-2Z | 2 | | 自备带入现场

3 | | PHL-03轮毂盖 | 2 | 6061 | 自备带入现场

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

2 | | PHL-03轮胎 | 2 | 橡胶（黑色） | 自备带入现场

1 | | PHL-03车轴 | 1 | SUS304 | 自备带入现场
序号 | 图号 | 名称 | 数量 | 材料 | 备注
设计 | 甄雪松 康远浩2020-10-30 | | 材料 | 零件名称 PHL-03车轮组件 | 中国兵器工业集团有限公司

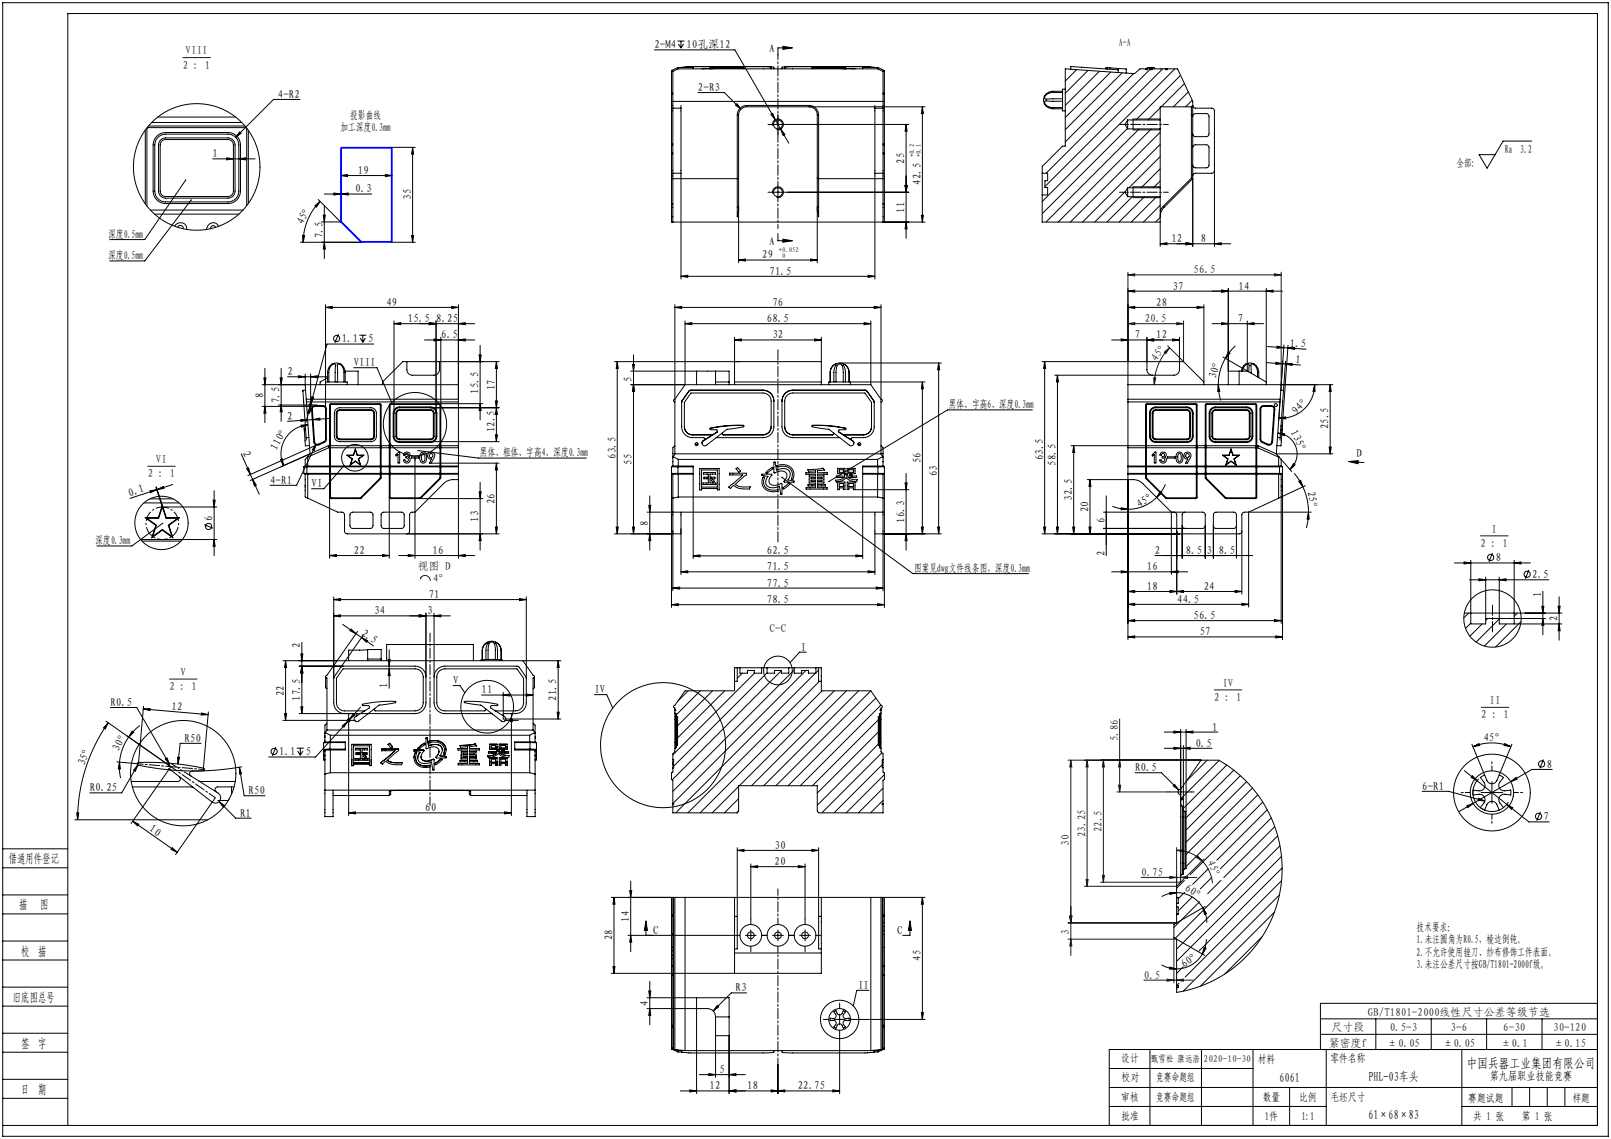
[picture p28: page 23]
甄雪松 康远浩

61×68×83 | 样题 赛题试题

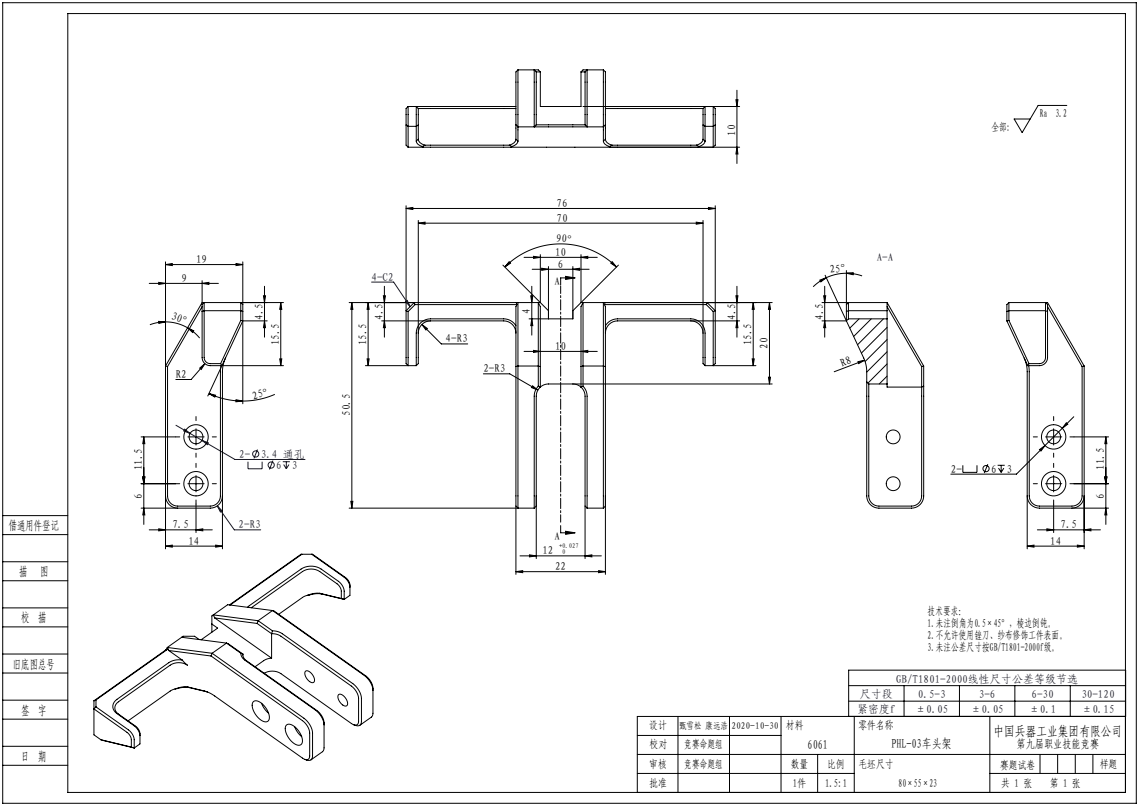
[picture p29: page 24]
甄雪松 康远浩

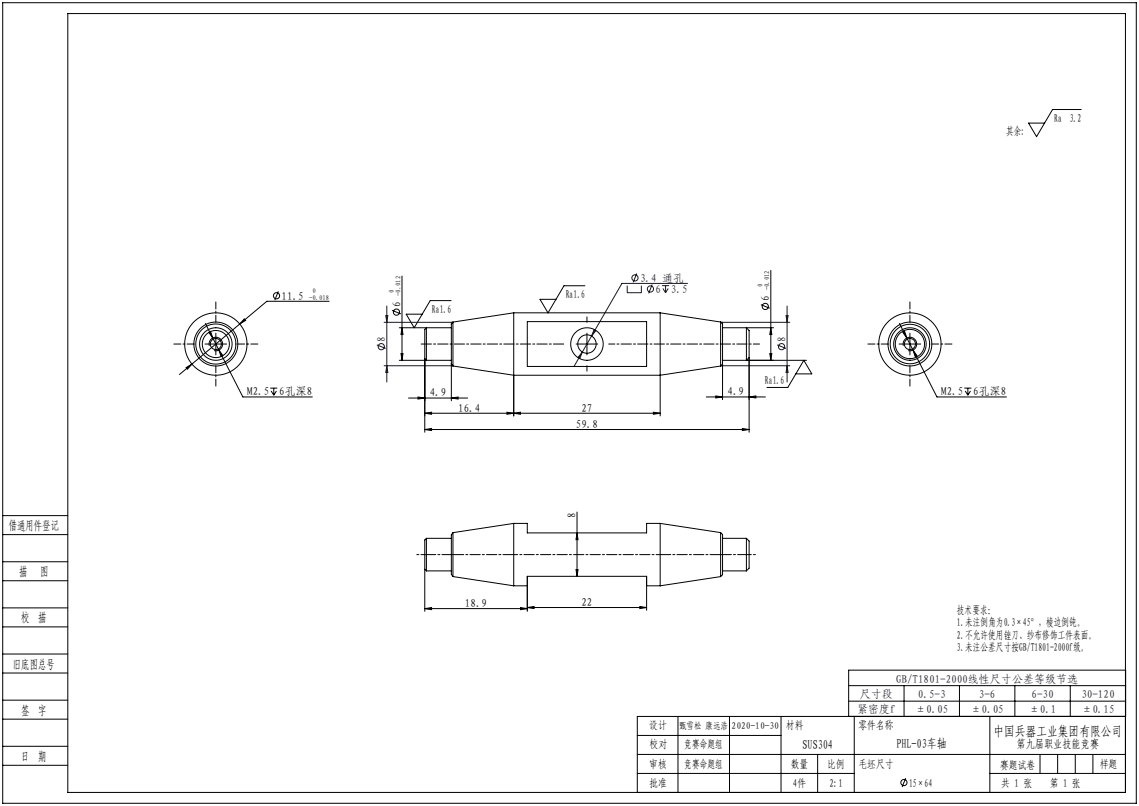
[picture p30: page 25]
甄雪松 康远浩

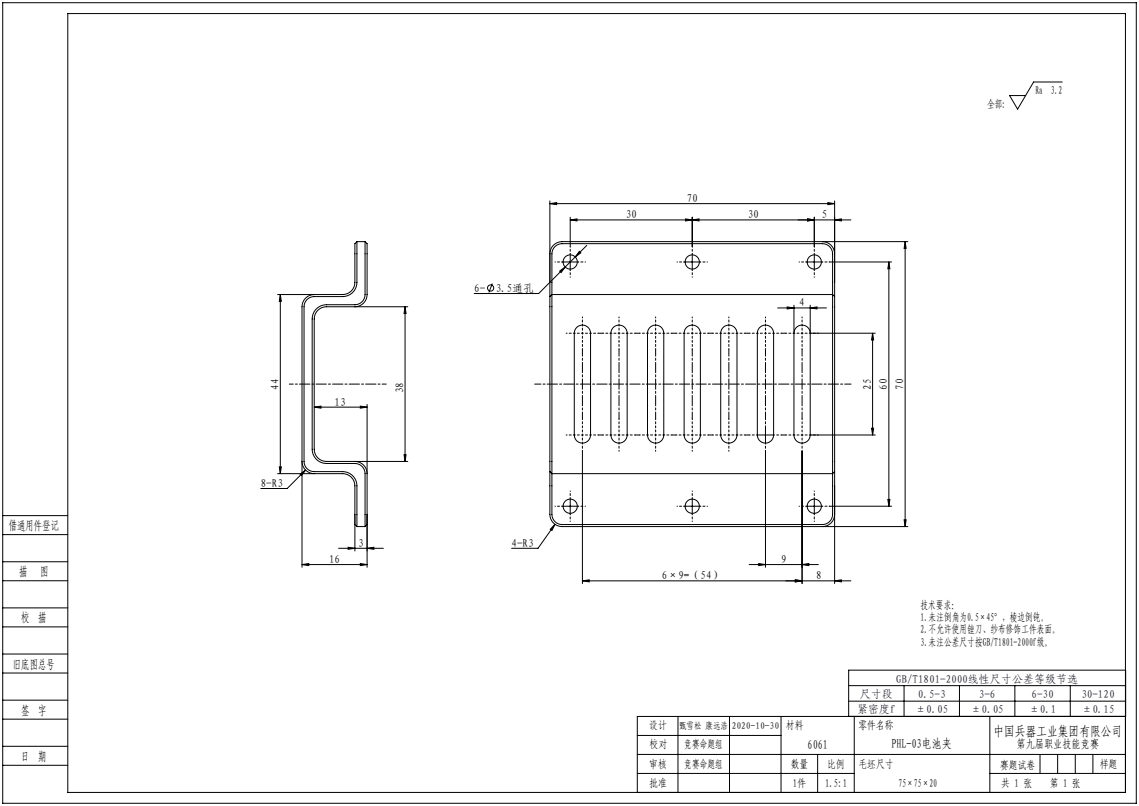
[picture p31: page 26]
甄雪松 康远浩

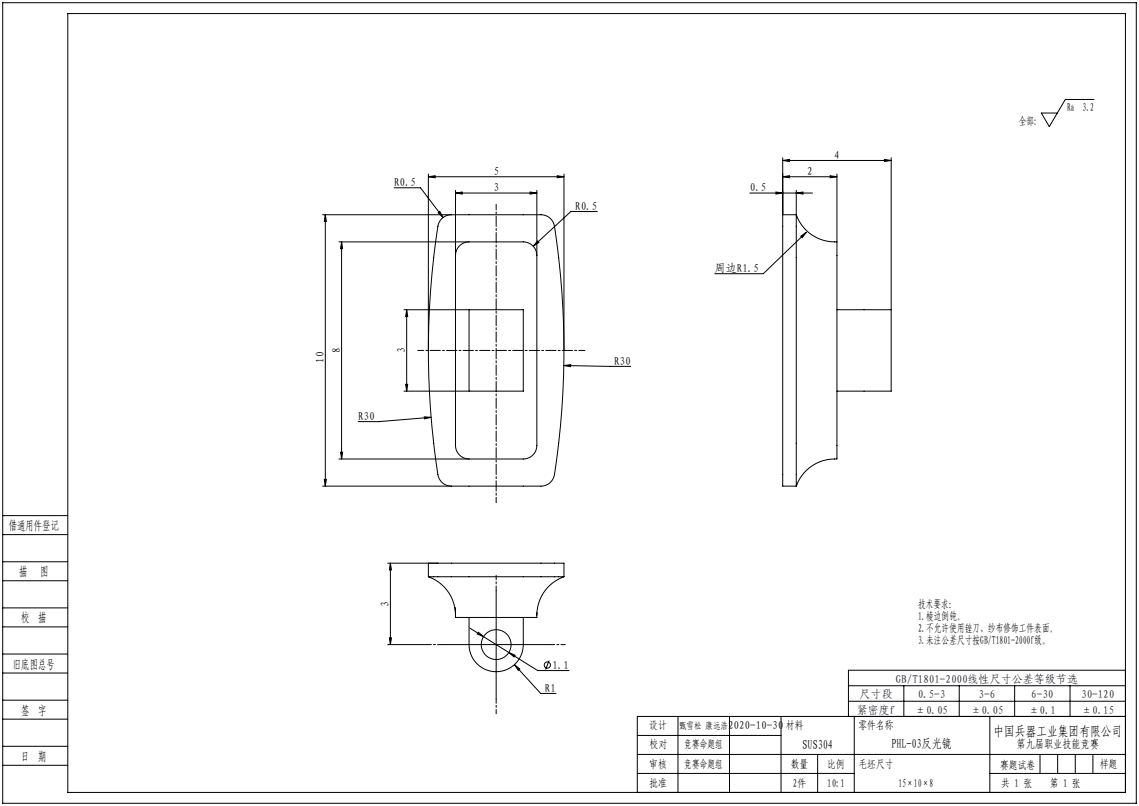
[picture p32: page 27]
甄雪松 康远浩2020-10-30

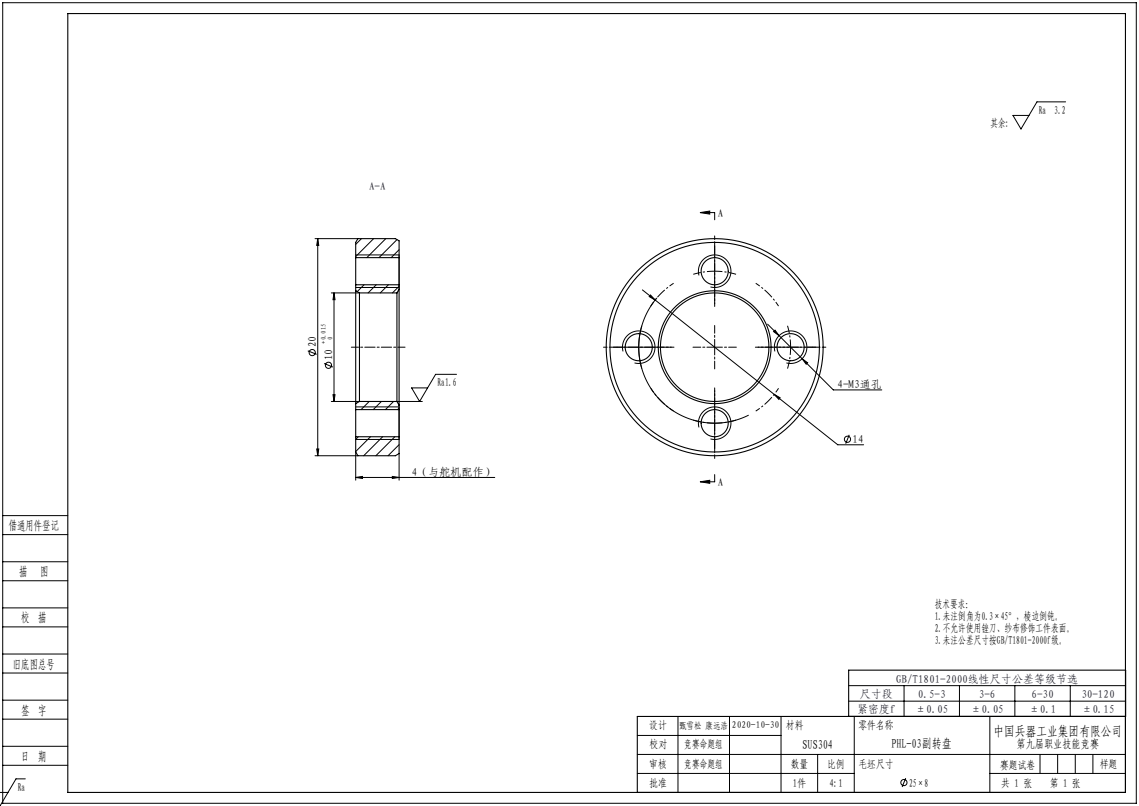
[picture p33: page 28]
甄雪松 康远浩

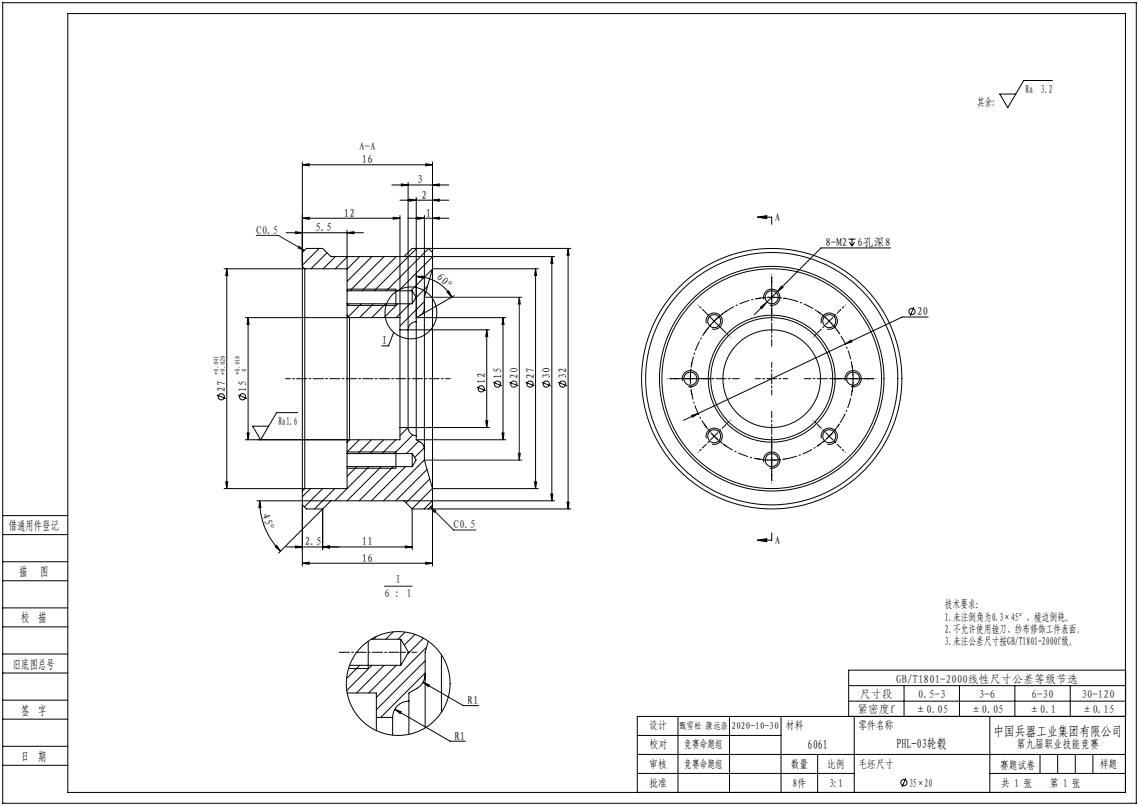
[picture p34: page 29]
甄雪松 康远浩

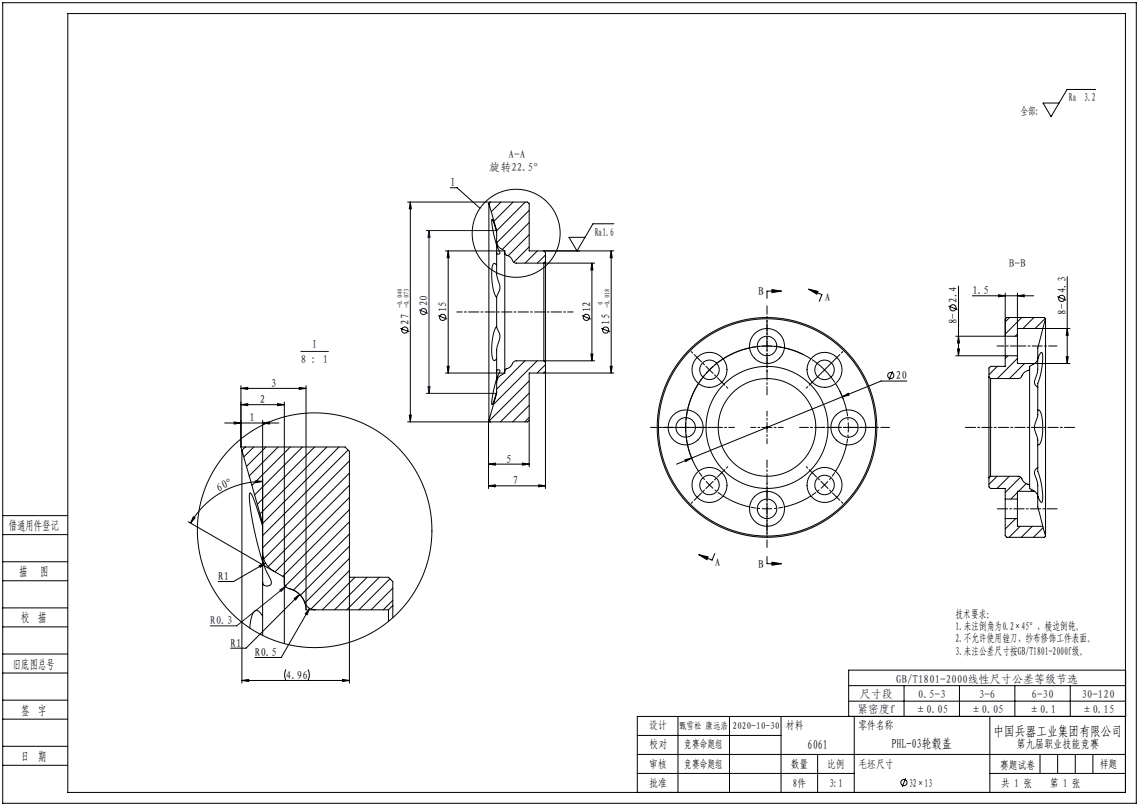
[picture p35: page 30]
甄雪松 康远浩

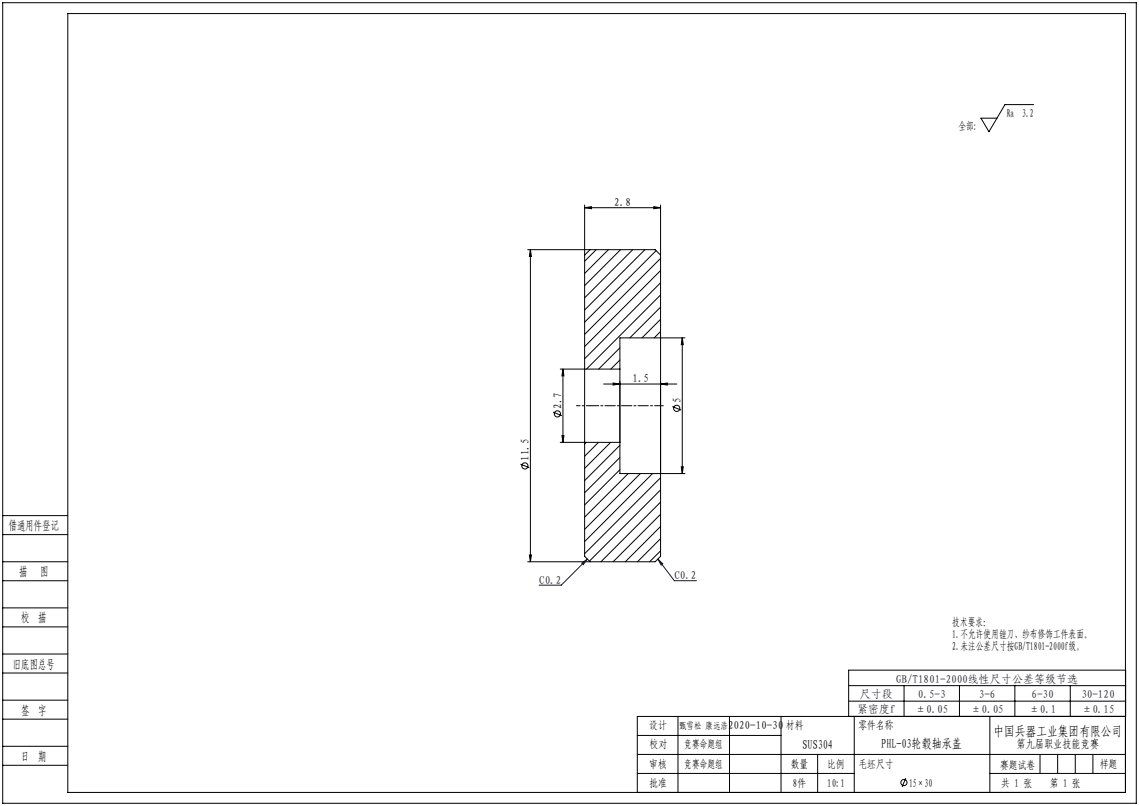
[picture p36: page 31]
甄雪松 康远浩2020-10-30

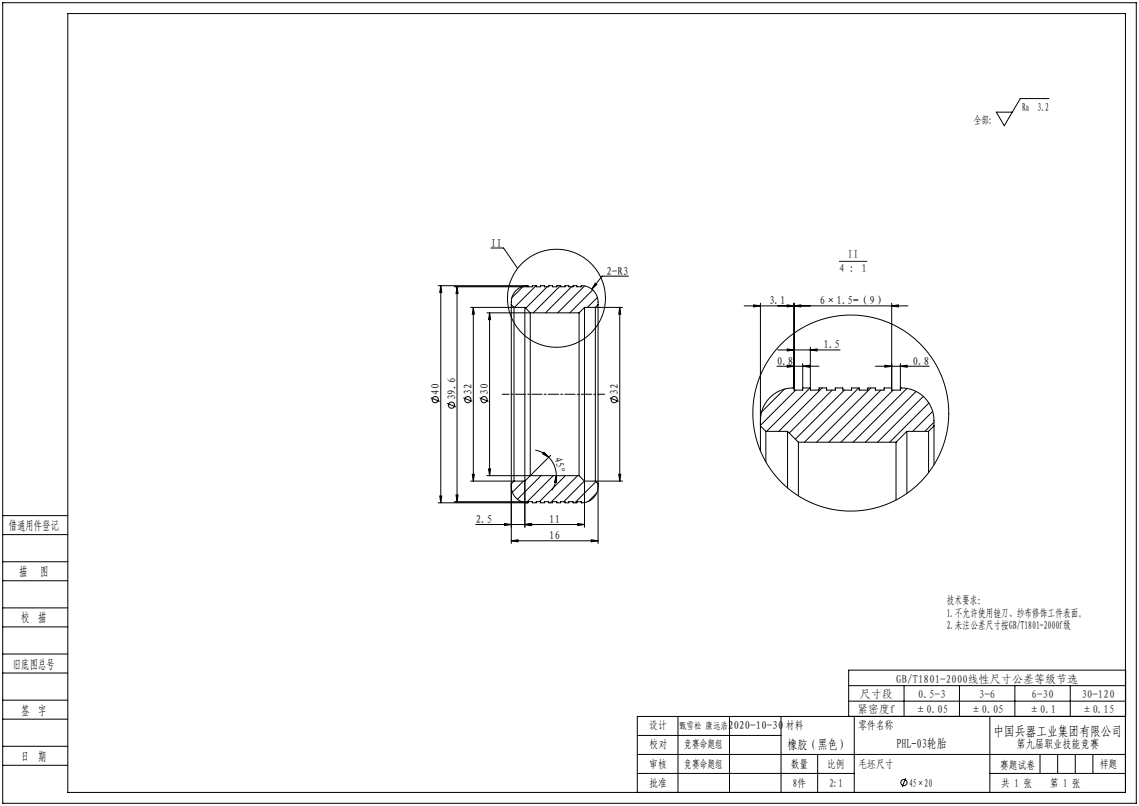
[picture p37: page 32]
甄雪松 康远浩2020-10-30

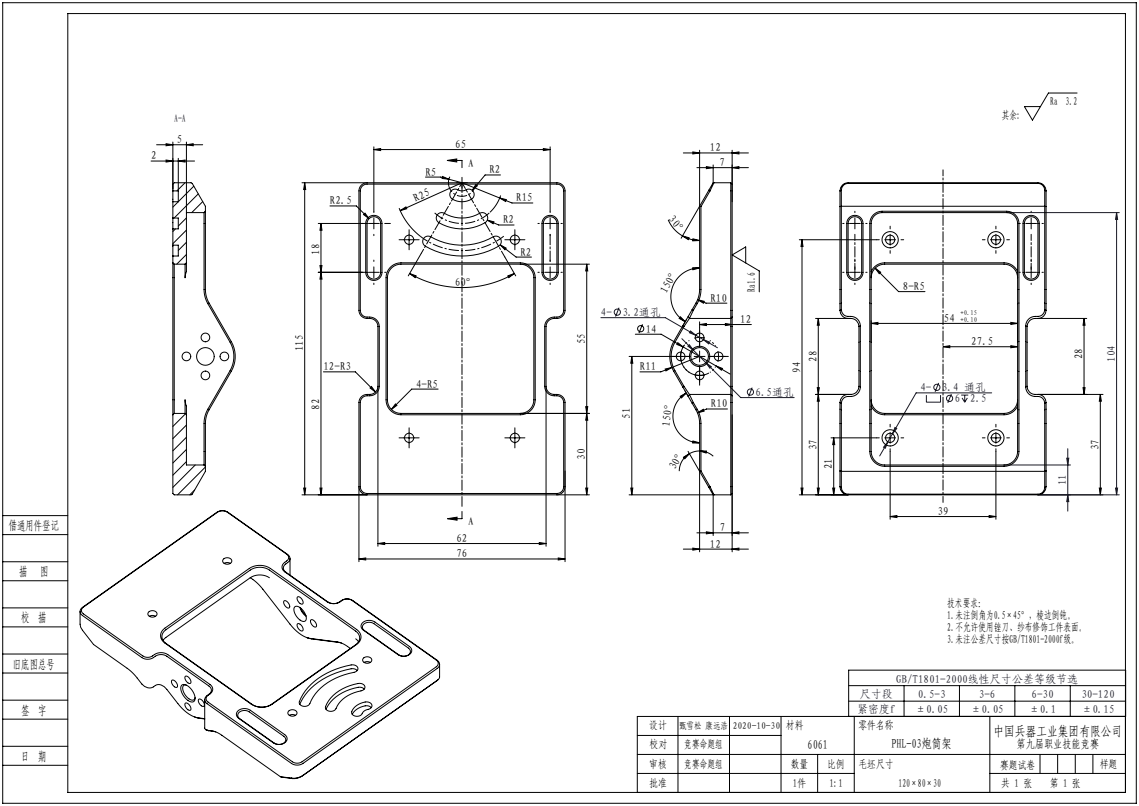
[picture p38: page 33]
甄雪松 康远浩

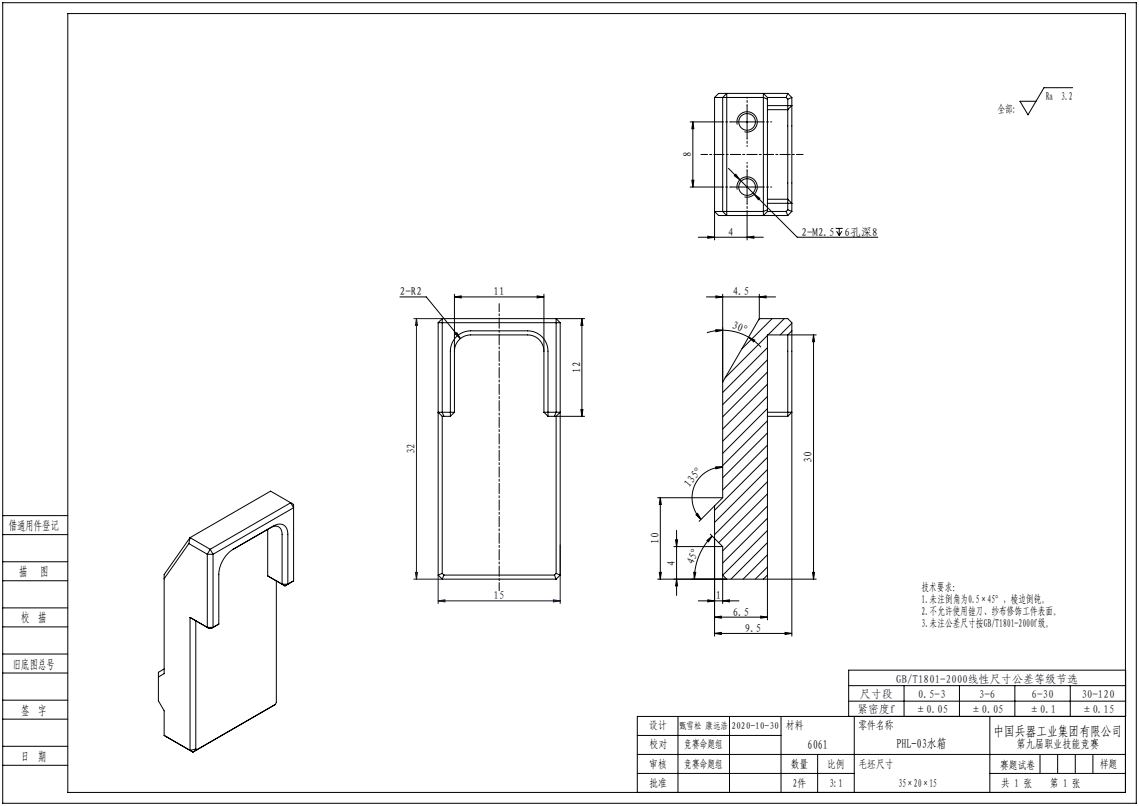
[picture p39: page 34]
甄雪松 康远浩

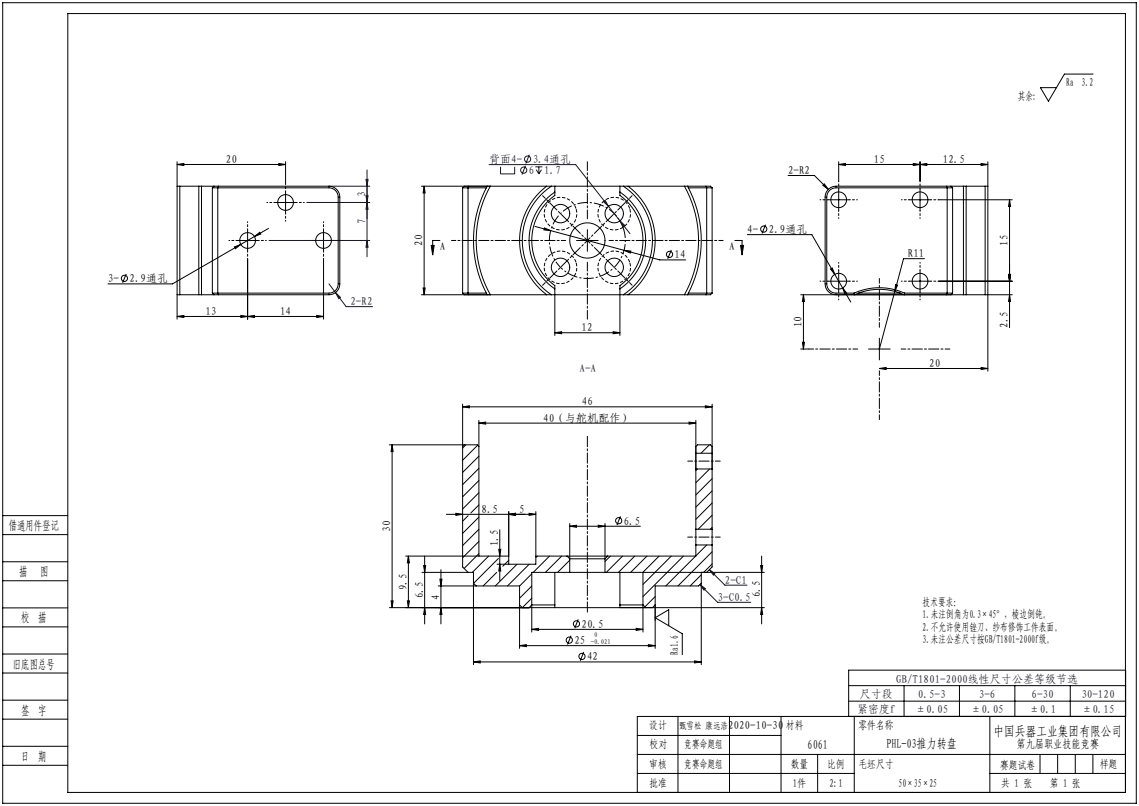
[picture p40: page 35]
甄雪松 康远浩2020-10-30

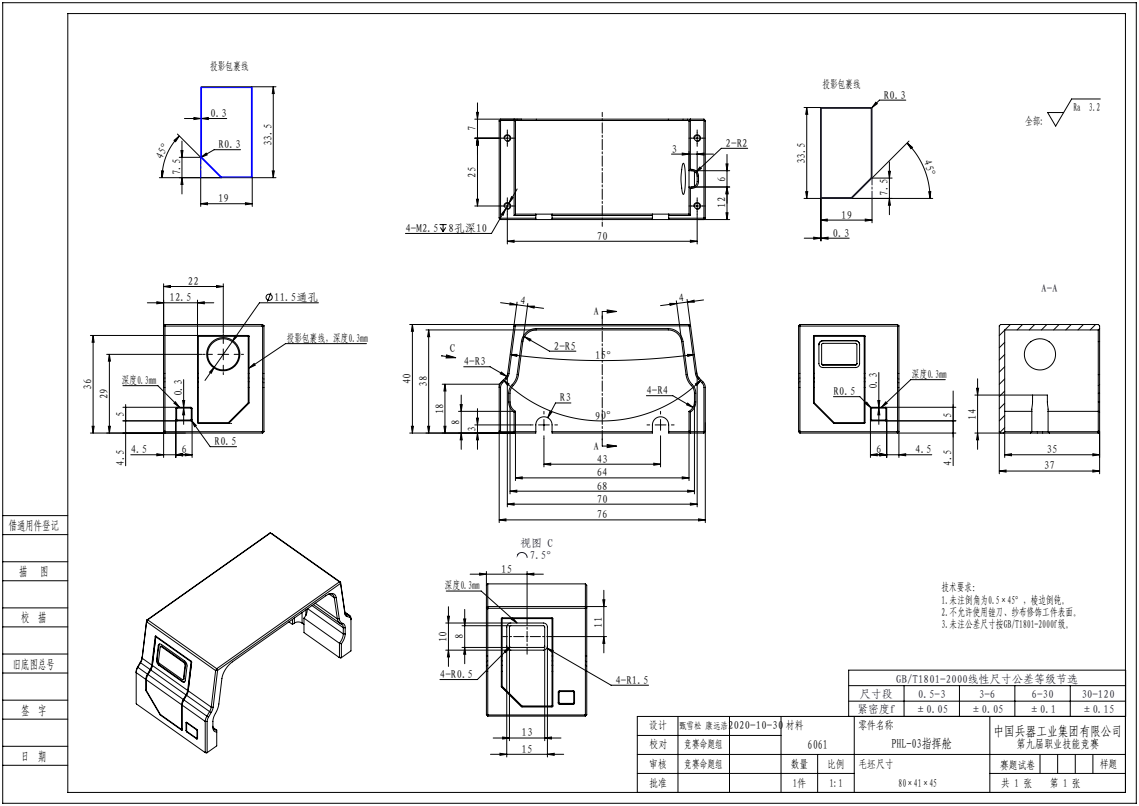
[picture p41: page 36]
甄雪松 康远浩2020-10-30

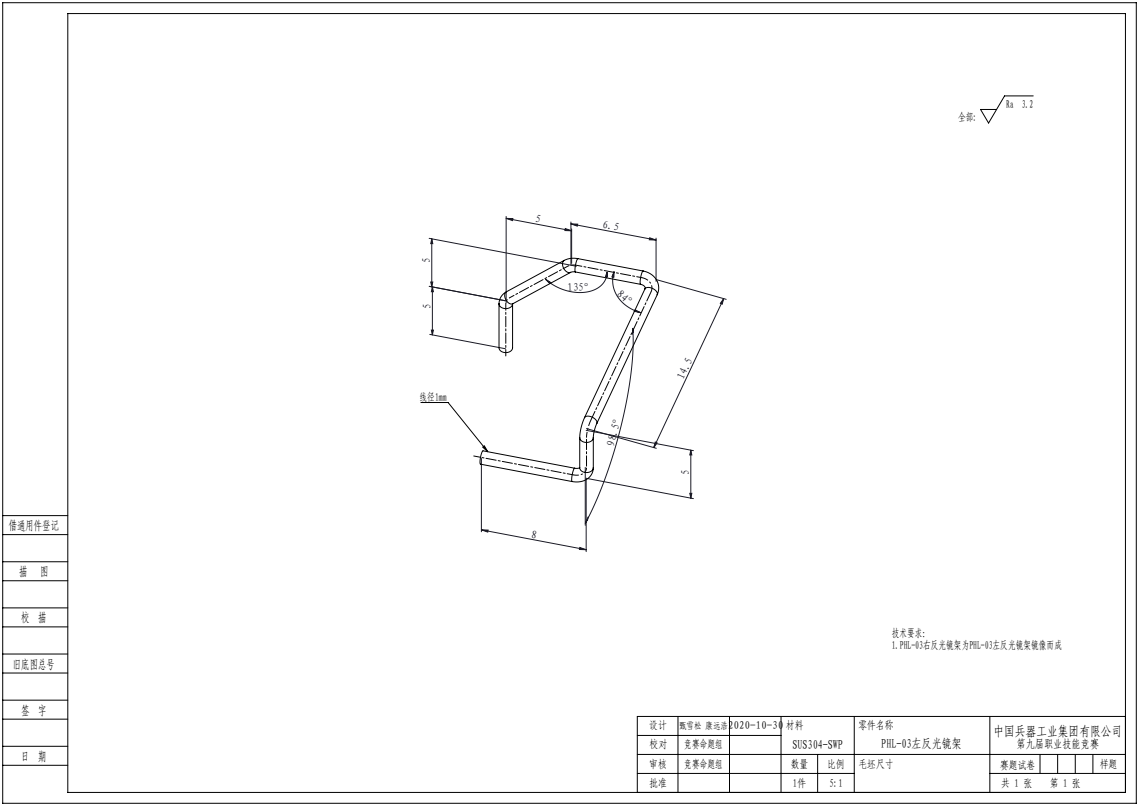
[picture p42: page 37]
甄雪松 康远浩2020-10-30
